svofski/vector06cc/doc/tangnano9k/WM8978-pinout.jpg

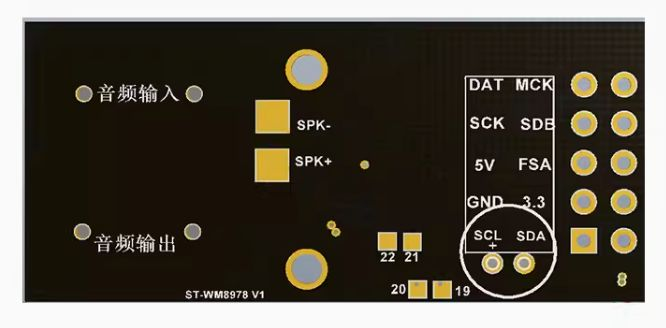
doc/tangnano9k/WM8978-pinout.jpg
