svofski/vector06cc/doc/tangnano9k/vsesp32s3.jpg

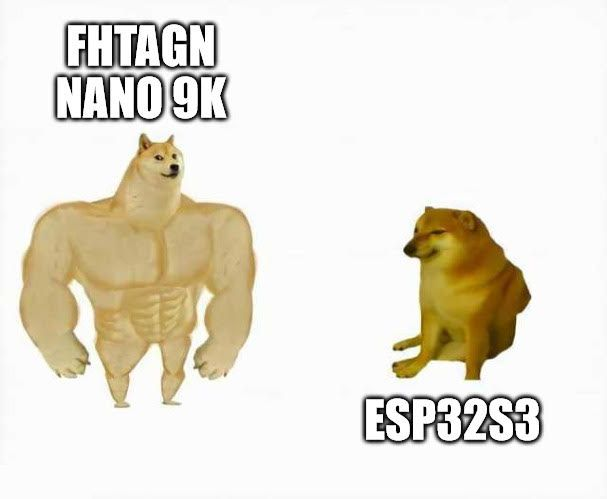
doc/tangnano9k/vsesp32s3.jpg
