svofski/vector06cc/hardware/vector06cc-tangnano9k/README.txt

vector06cc-specific carrier board for Tang Nano 9k
