svofski/vector06cc/doc/clocks-2.png

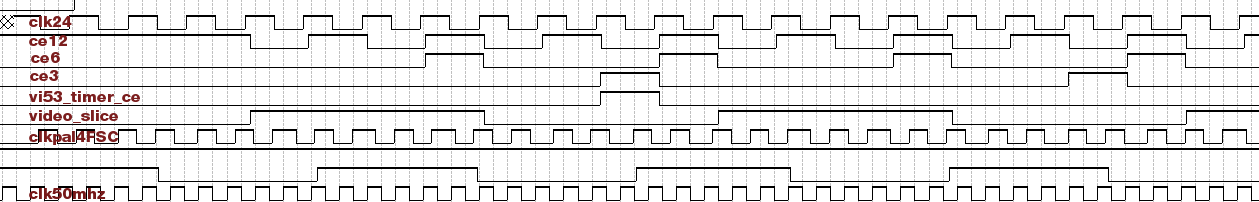
doc/clocks-2.png
