svofski/vector06cc/doc/computer.png

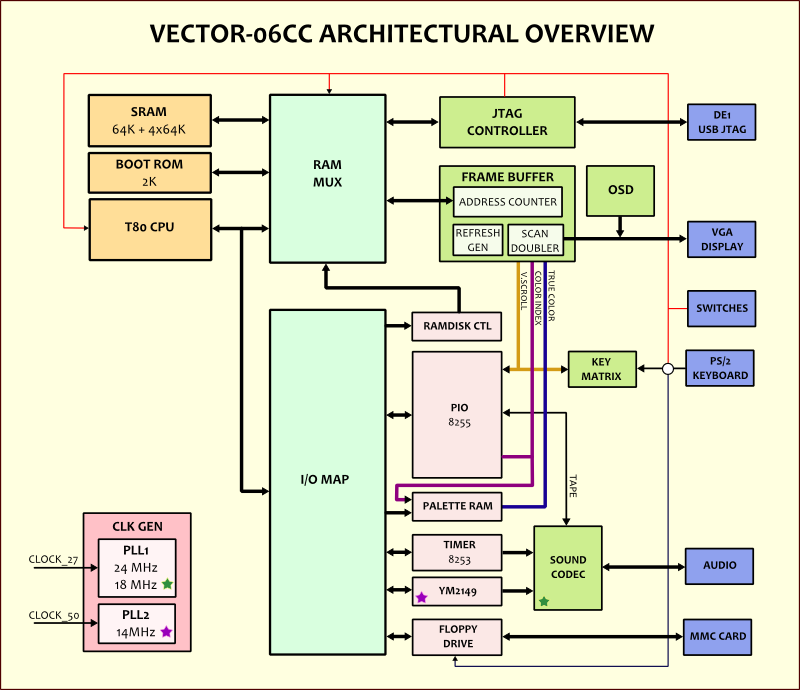
doc/computer.png
