svofski/vector06cc/doc/floppy.png

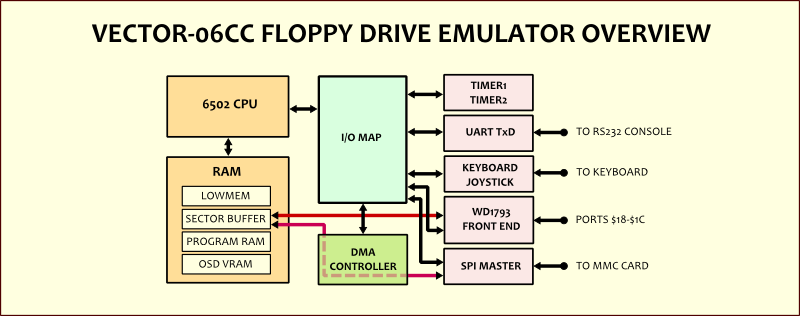
doc/floppy.png
