svofski/vector06cc/doc/jtag_statemachine.png

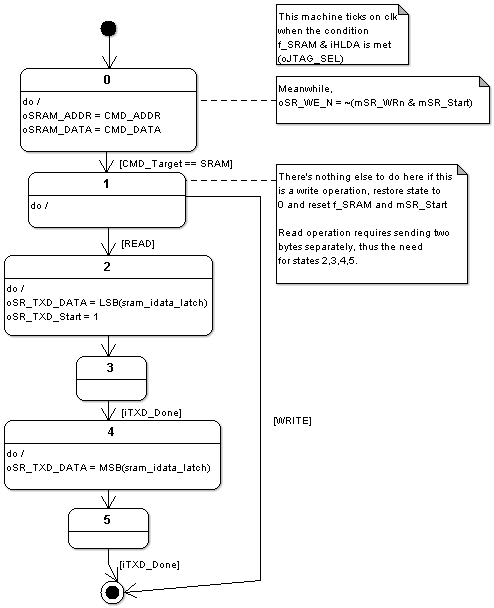
doc/jtag_statemachine.png
