svofski/vector06cc/doc/putupchik.jpg

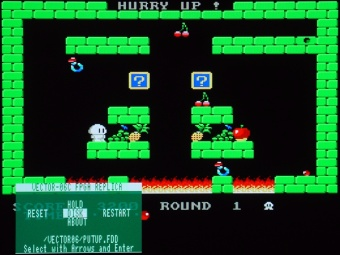
doc/putupchik.jpg
