svofski/vector06cc/doc/tangnano9k/keyboard-host-CH9350DS.jpg

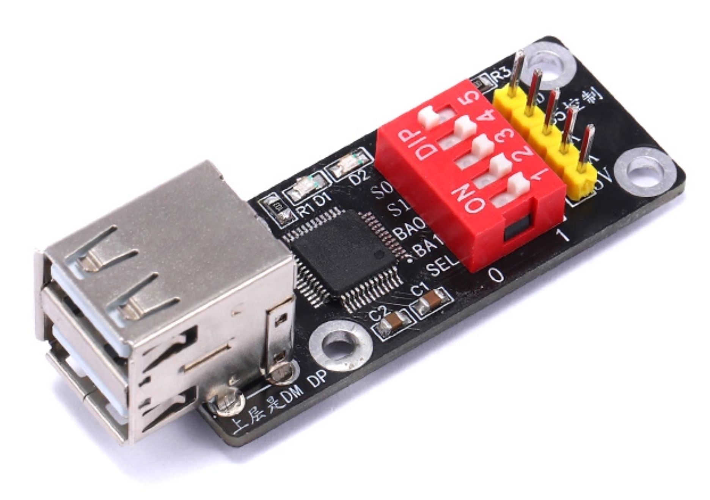
doc/tangnano9k/keyboard-host-CH9350DS.jpg
