svofski/vector06cc/doc/tangnano9k/pwm-output.jpg

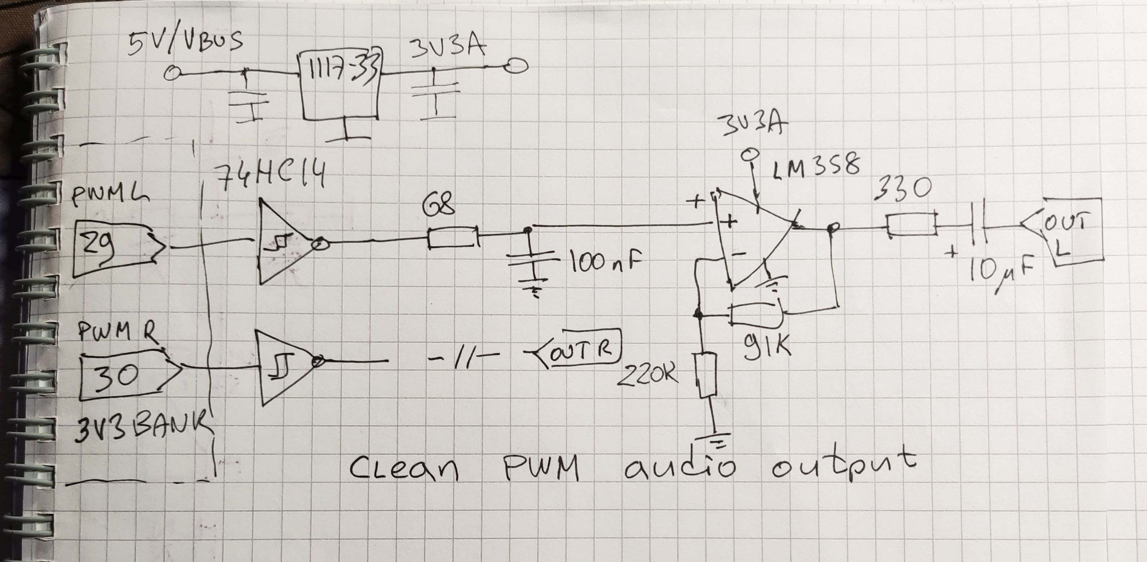
doc/tangnano9k/pwm-output.jpg
