svofski/vector06cc/doc/tangnano9k/vertical-interpolation.jpg

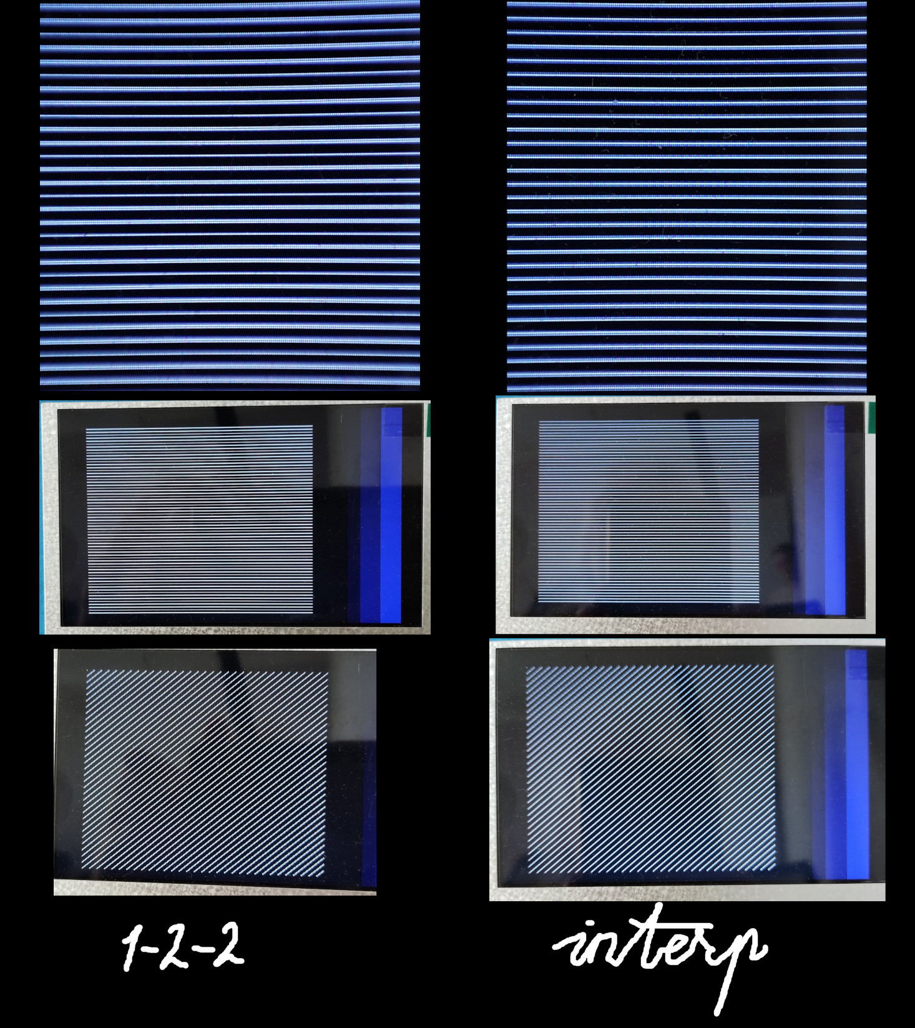
doc/tangnano9k/vertical-interpolation.jpg
