svofski/vector06cc/doc/tangnano9k/WM8978-board.jpg

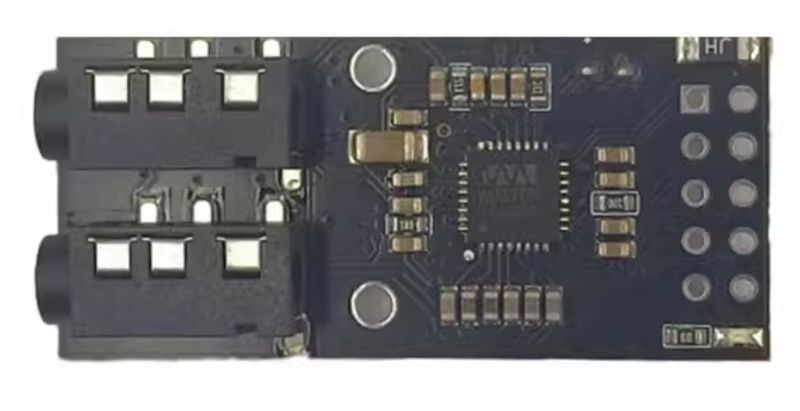
doc/tangnano9k/WM8978-board.jpg
