svofski/vector06cc/doc/tangnano9k/WM8978-schematic.jpg

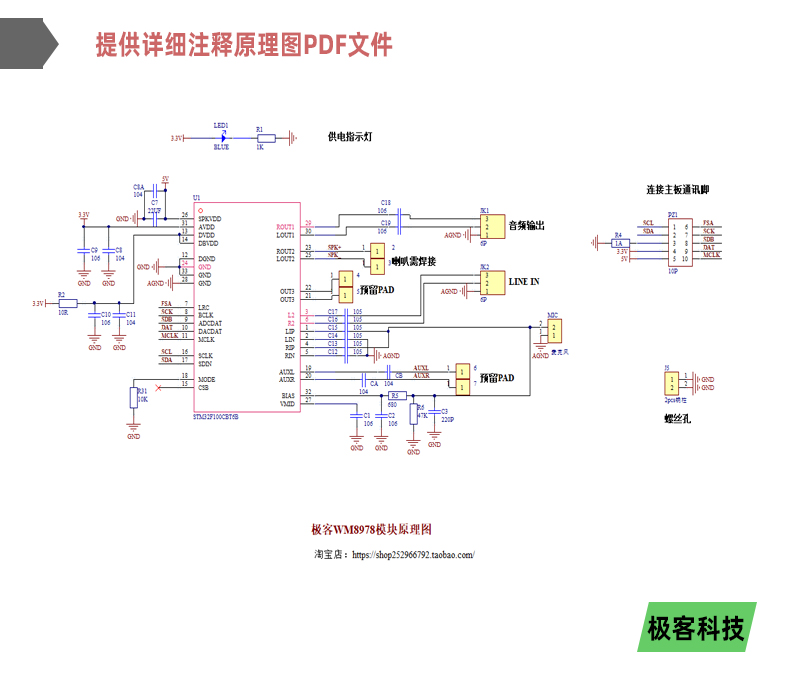
doc/tangnano9k/WM8978-schematic.jpg
