svofski/vector06cc/doc/wd_statemachine.png

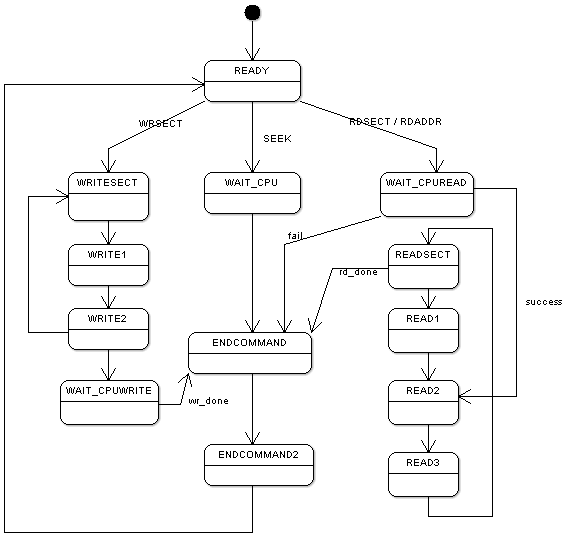
doc/wd_statemachine.png
