svofski/vector06cc/hardware/vector06cc-tangnano9k/kicad/v06cc_tn9k/v06cc_tn9k.kicad_pcb

## KiCad design hardware/vector06cc-tangnano9k/kicad/v06cc_tn9k/v06cc_tn9k.kicad_pcb (2024-10-20)

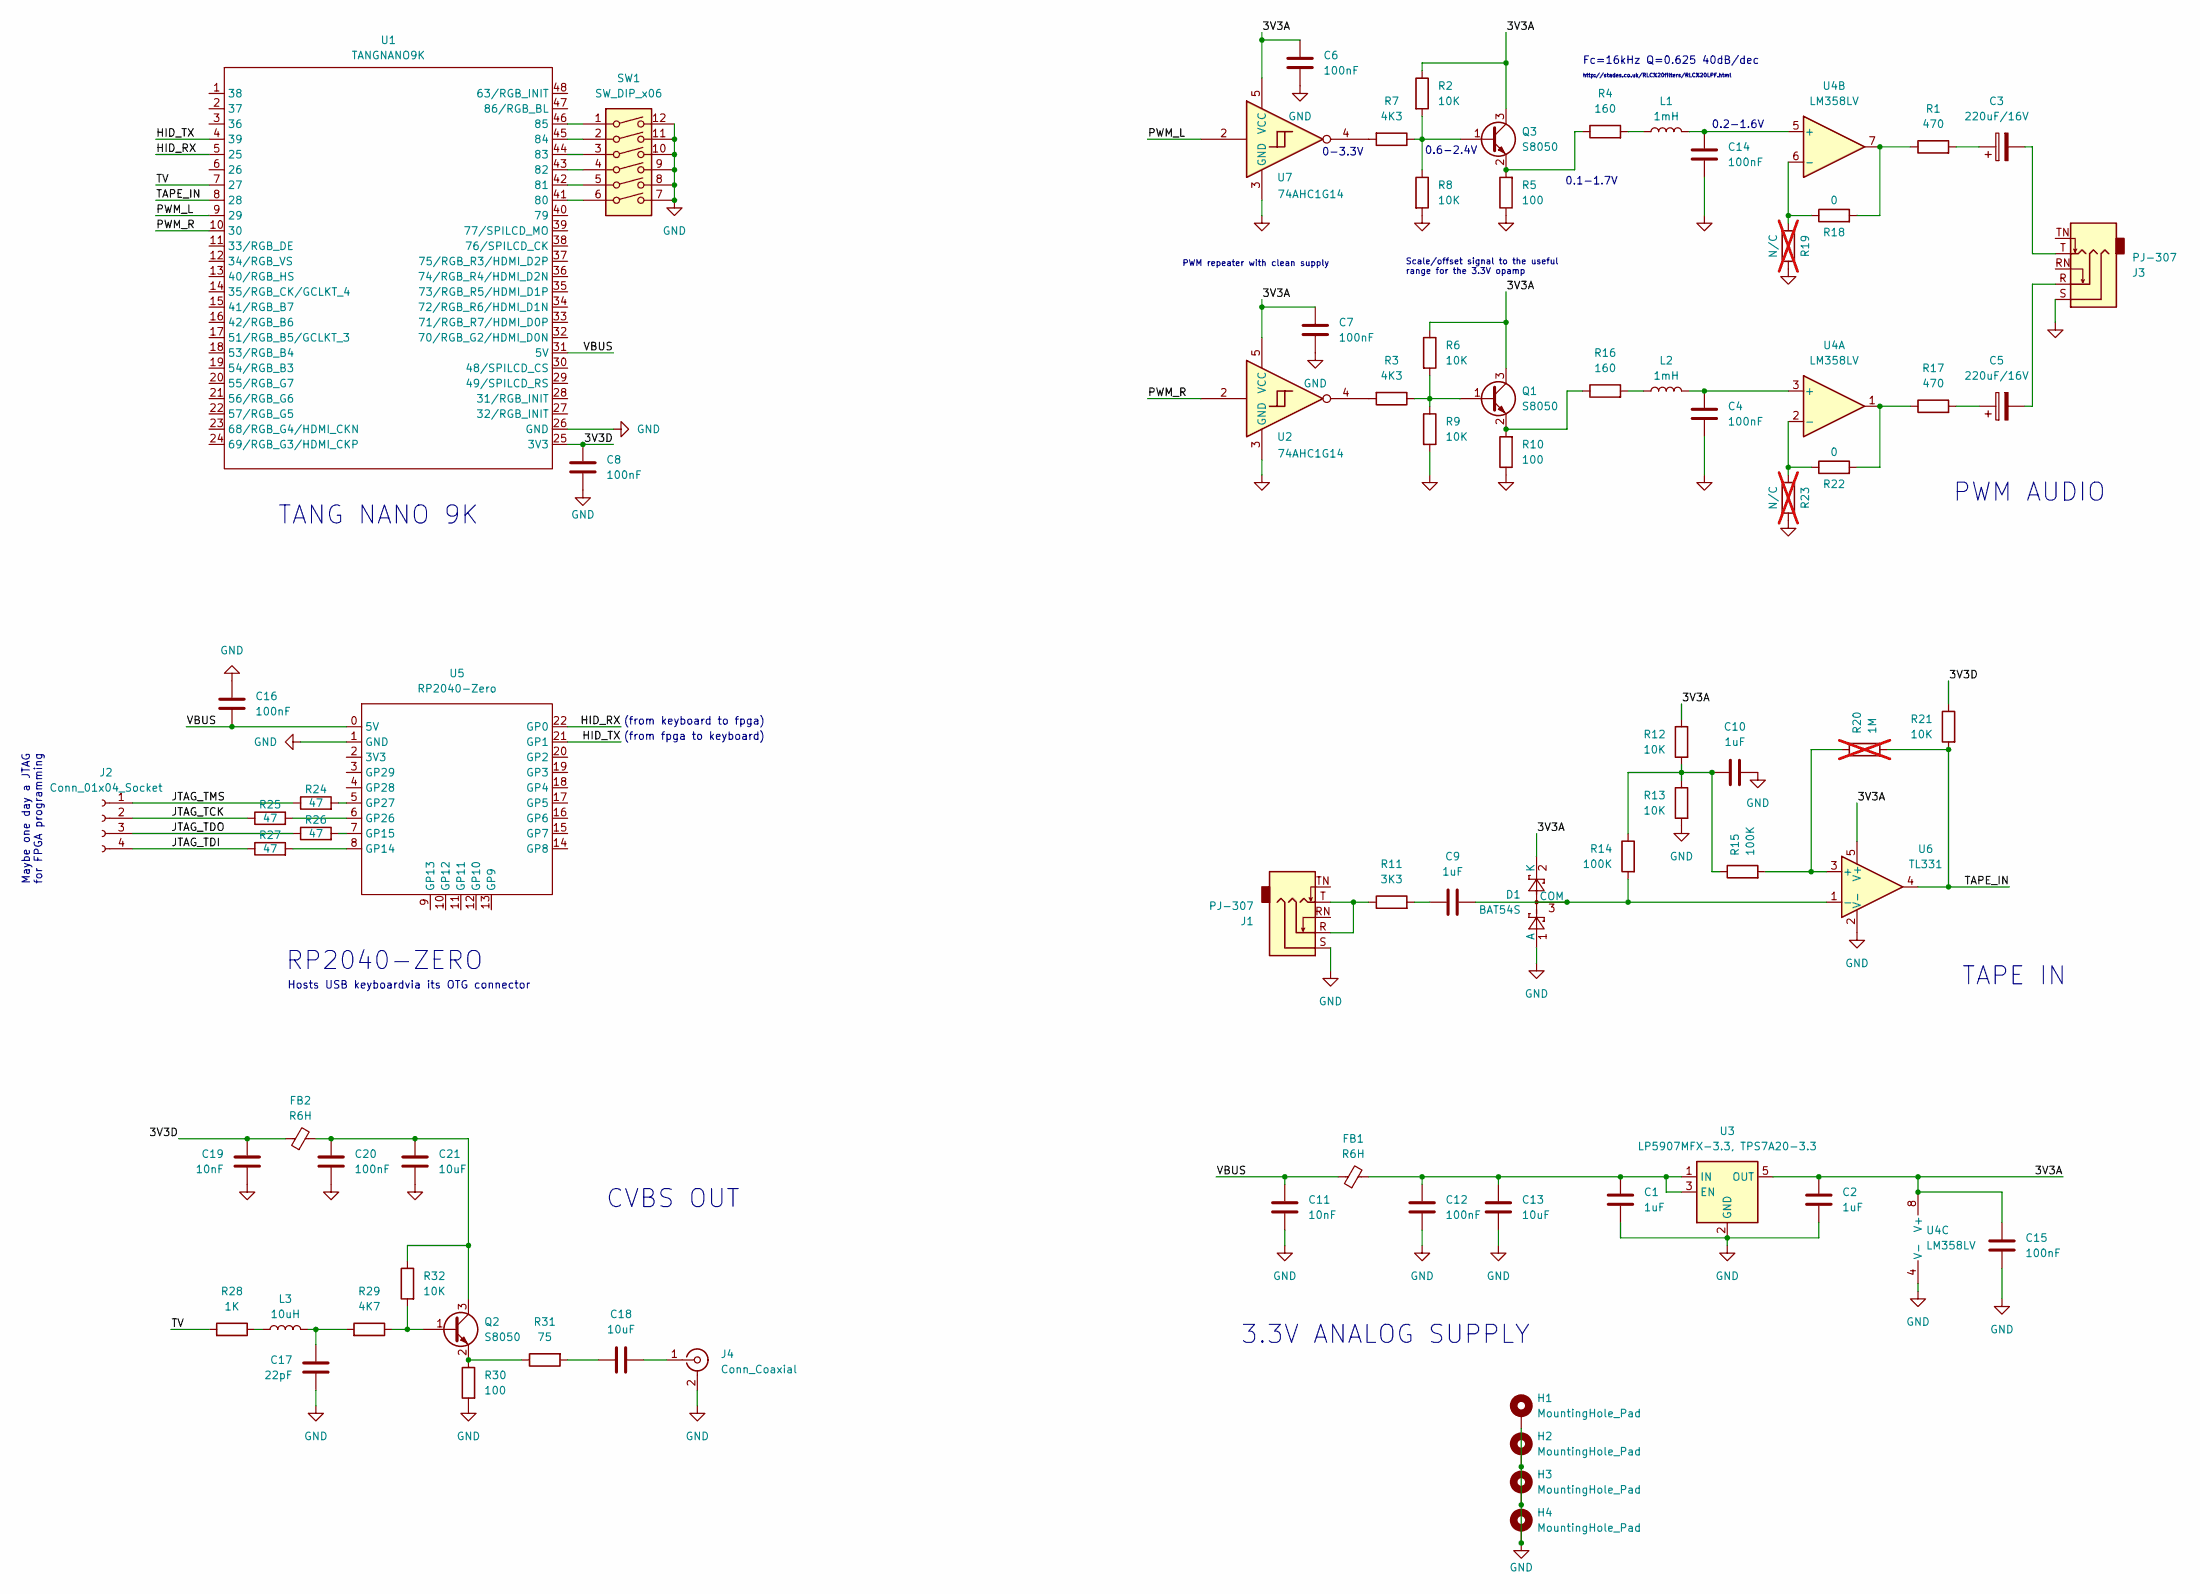
[picture p14: schematic v06cc_tn9k.kicad_sch, VECTOR06CC TANG NANO 9K CARRIER BOARD]

Parts:
C1, C2, C9, C10: 1uF; C_0805_2012Metric
C3, C5: 220uF/16V; CP_Elec_6.3x7.7
C4, C6, C7, C8, C12, C14, C15, C16, C20: 100nF; C_0603_1608Metric
C11, C19: 10nF; C_0805_2012Metric
C13, C18, C21: 10uF; C_0805_2012Metric
C17: 22pF; C_0603_1608Metric
D1: BAT54S; SOT-23
FB1, FB2: R6H; L_Radial_D6.0mm_P4.00mm
H1, H2, H3, H4: MountingHole_Pad; MountingHole_3.2mm_M3_DIN965_Pad
J1, J3: PJ-307; Jack_3.5mm_CUI_SJ1-3525N_Horizontal
J2: Conn_01x04_Socket; PinSocket_1x04_P2.54mm_Vertical
J4: Conn_Coaxial; CUI_RCJ-013
L1, L2: 1mH; L_Radial_D7.2mm_P3.00mm_Murata_1700
L3: 10uH; L_0805_2012Metric
Q1, Q2, Q3: S8050; SOT-23
R1, R17: 470; R_0805_2012Metric
R2, R6, R8, R9, R12, R13, R21, R32: 10K; R_0805_2012Metric
R3, R7: 4K3; R_0805_2012Metric
R4, R16: 160; R_0805_2012Metric
R5, R10, R30: 100; R_0805_2012Metric
R11: 3K3; R_0805_2012Metric
R14, R15: 100K; R_0805_2012Metric
R18, R22: 0; R_0805_2012Metric
R19, R23: N/C; R_0805_2012Metric; not fitted
R20: 1M; R_0805_2012Metric; not fitted
R24, R25, R26, R27: 47; R_0805_2012Metric
R28: 1K; R_0805_2012Metric
R29: 4K7; R_0805_2012Metric
R31: 75; R_0805_2012Metric
SW1: SW_DIP_x06; SW_DIP_SPSTx06_Slide_9.78x17.42mm_W7.62mm_P2.54mm
U1: TANGNANO9K; TangNano9k
U2, U7: 74AHC1G14; SOT-23-5
U3: LP5907MFX-3.3, TPS7A20-3.3; SOT-23-5
U4: LM358LV; SOIC-8_3.9x4.9mm_P1.27mm
U5: RP2040-Zero; rp2040-zero
U6: TL331; SOT-23-5

Connections:
/3V3A: C2.1, C6.2, C7.2, C15.2, D1.2 (K), Q1.3 (C), Q3.3 (C), R2.1, R6.1, R12.1, U2.5 (VCC), U3.5 (OUT), U4.8 (V+), U6.5 (V+), U7.5 (VCC)
/3V3D: C8.2, C19.1, FB2.1, R21.1, U1.25 (3V3)
/HID_RX: U1.5 (25), U5.22 (GP0)
/HID_TX: U1.4 (39), U5.21 (GP1)
/JTAG_TCK: J2.2, R25.1
/JTAG_TDI: J2.4, R27.1
/JTAG_TDO: J2.3, R26.1
/JTAG_TMS: J2.1, R24.1
/PWM_L: U1.9 (29), U7.2
/PWM_R: U1.10 (30), U2.2
/TAPE_IN: R20.2, R21.2, U1.8 (28), U6.4
/TV: R28.2, U1.7 (27)
/VBUS: C11.1, C16.1, FB1.1, U1.31 (5V), U5.0 (5V)
GND: C1.2, C2.2, C4.1, C6.1, C7.1, C8.1, C10.2, C11.2, C12.2, C13.2, C14.1, C15.1, C16.2, C17.1, C19.2, C20.2, C21.2, D1.1 (A), H1.1, H2.1, H3.1, H4.1, J1.S, J3.S, J4.2 (Ext), R5.1, R8.2, R9.2, R10.1, R13.2, R19.1, R23.1, R30.2, SW1.7, SW1.8, SW1.9, SW1.10, SW1.11, SW1.12, U1.26 (GND), U2.3 (GND), U3.2 (GND), U4.4 (V-), U5.1 (GND), U6.2 (V-), U7.3 (GND)
unnamed: C3.1, R1.2
unnamed: C3.2, J3.T
unnamed: C5.1, R17.2
unnamed: C5.2, J3.R
unnamed: C9.1, R11.2
unnamed: C10.1, R12.2, R13.1, R14.1, R15.1
unnamed: C17.2, L3.1, R29.2
unnamed: C18.1, R31.2
unnamed: C9.2, D1.3 (COM), R14.2, U6.1 (-)
unnamed: J1.R, J1.T, R11.1
unnamed: C18.2, J4.1 (In)
unnamed: L1.1, R4.2
unnamed: L2.1, R16.2
unnamed: L3.2, R28.1
unnamed: Q1.1 (B), R3.1, R6.2, R9.1
unnamed: Q1.2 (E), R10.2, R16.1
unnamed: Q2.1 (B), R29.1, R32.2
unnamed: C20.1, C21.1, FB2.2, Q2.3 (C), R32.1
unnamed: Q2.2 (E), R30.1, R31.1
unnamed: Q3.1 (B), R2.2, R7.1, R8.1
unnamed: Q3.2 (E), R4.1, R5.2
unnamed: R1.1, R18.2, U4.7
unnamed: R3.2, U2.4
unnamed: R7.2, U7.4
unnamed: R17.1, R22.2, U4.1
unnamed: SW1.6, U1.41 (80)
unnamed: SW1.5, U1.42 (81)
unnamed: SW1.4, U1.43 (82)
unnamed: SW1.3, U1.44 (83)
unnamed: SW1.2, U1.45 (84)
unnamed: SW1.1, U1.46 (85)
unnamed: C1.1, C12.1, C13.1, FB1.2, U3.1 (IN), U3.3 (EN)
unnamed: C4.2, L2.2, U4.3 (+)
unnamed: R22.1, R23.2, U4.2 (-)
unnamed: C14.2, L1.2, U4.5 (+)
unnamed: R18.1, R19.2, U4.6 (-)
unnamed: R27.2, U5.8 (GP14)
unnamed: R26.2, U5.7 (GP15)
unnamed: R25.2, U5.6 (GP26)
unnamed: R24.2, U5.5 (GP27)
unnamed: R15.2, R20.1, U6.3 (+)

Notes on the sheet:
PWM AUDIO
Hosts USB keyboardvia its OTG connector
(from keyboard to fpga)
http://stades.co.uk/RLC%20filters/RLC%20LPF.html
Maybe one day a JTAG for FPGA programming
3.3V ANALOG SUPPLY
0.6-2.4V
0.2-1.6V
Scale/offset signal to the useful range for the 3.3V opamp
PWM repeater with clean supply
(from fpga to keyboard)
0.1-1.7V
RP2040-ZERO
Fc=16kHz Q=0.625 40dB/dec
TAPE IN
0-3.3V
CVBS OUT
TANG NANO 9K

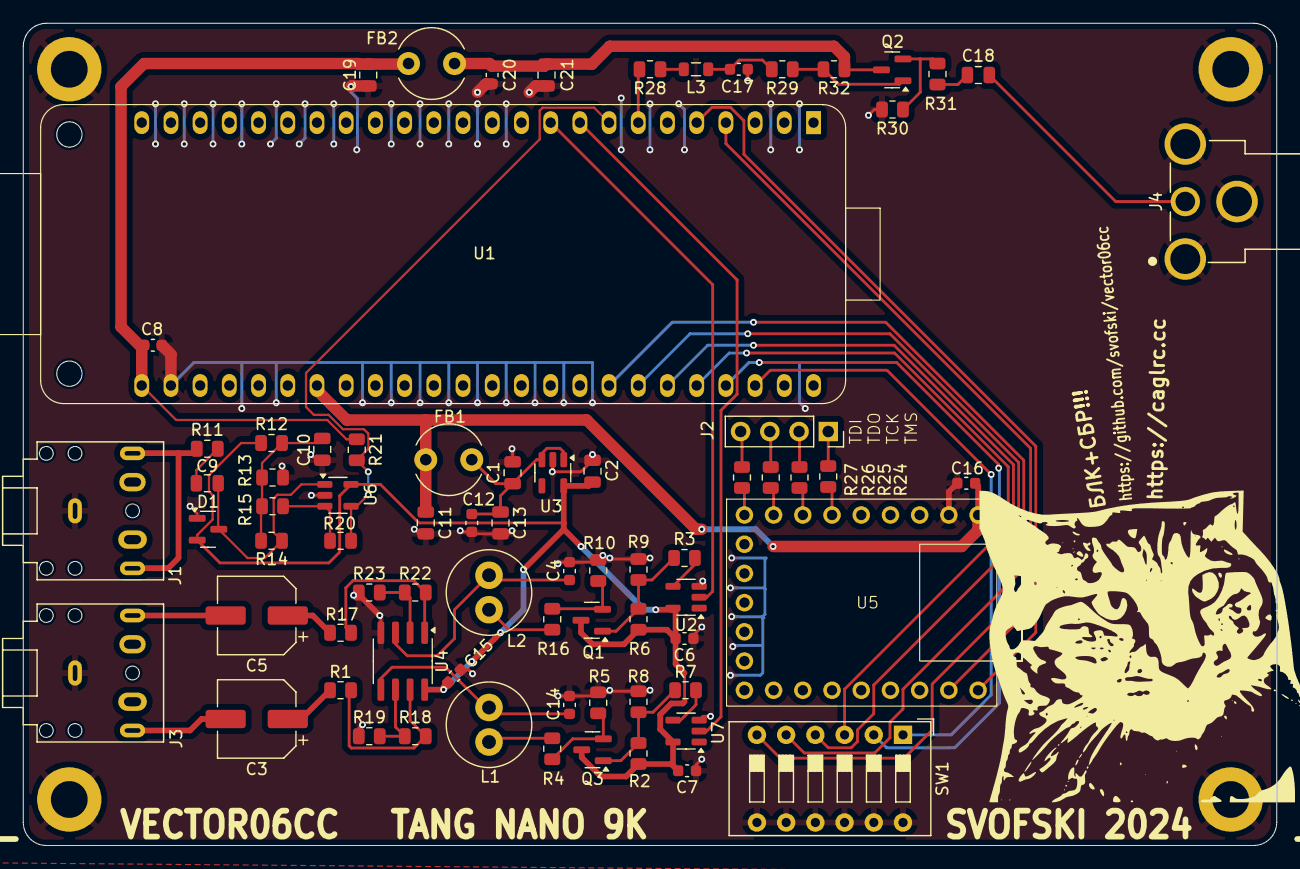
[picture p15: board v06cc_tn9k.kicad_pcb from above]

Board: 2 copper layers, 109.0 x 71.5 mm, 78 parts (0 on the bottom side), 55 nets.
