svofski/vector06cc/pico/v06c_usbhid/main.c

/* 
 * The MIT License (MIT)
 *
 * Copyright (c) 2019 Ha Thach (tinyusb.org)
 *
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
 */

#include <stdlib.h>
#include <stdio.h>
#include <string.h>

#include "bsp/board.h"
#include "tusb.h"

#include "matrix.h"

//--------------------------------------------------------------------+
// MACRO CONSTANT TYPEDEF PROTYPES
//--------------------------------------------------------------------+
void led_blinking_task(void);

extern void cdc_app_task(void);
extern void hid_app_task(void);

/*------------- MAIN -------------*/
int main(void)
{
  board_init();

  printf("TinyUSB Host CDC MSC HID Example\r\n");

  // init host stack on configured roothub port
  tuh_init(BOARD_TUH_RHPORT);
  matrix_init();

  while (1)
  {
    // tinyusb host task
    tuh_task();

    led_blinking_task();
    cdc_app_task();
    hid_app_task();
  }

  return 0;
}

//--------------------------------------------------------------------+
// TinyUSB Callbacks
//--------------------------------------------------------------------+

void tuh_mount_cb(uint8_t dev_addr)
{
  // application set-up
  printf("A device with address %d is mounted\r\n", dev_addr);
}

void tuh_umount_cb(uint8_t dev_addr)
{
  // application tear-down
  printf("A device with address %d is unmounted \r\n", dev_addr);
}


//--------------------------------------------------------------------+
// Blinking Task
//--------------------------------------------------------------------+
void led_blinking_task(void)
{
  const uint32_t interval_ms = 1000;
  static uint32_t start_ms = 0;

  static bool led_state = false;

  // Blink every interval ms
  if ( board_millis() - start_ms < interval_ms) return; // not enough time
  start_ms += interval_ms;

  board_led_write(led_state);
  led_state = 1 - led_state; // toggle
}
