svofski/vector06cc/src/tangnano9k/psram/psram_controller.v

//
// PSRAM/HyperRAM controller for Tang Nano 9K / Gowin GW1NR-LV9QN88PC6/15.
// Feng Zhou, 2022.8
//
// This is a word or byte based, non-bursting controller for accessing the on-chip HyperRAM.
// - 1:1 clock design. Memory and main logic work under the same clock.
// - Low latency. Under default settings, write latency is 7 cycles (1x) or 10 cycles (2x). 
//   Read latency is 12 cycles (1x) or 15 cycles(2x). In my test, 2x latency happens about 
//   0.05% of time.

// Modified by svofski 19.10.2024: updated FSM to case

`default_nettype wire

module PsramController #(
    parameter FREQ=81_000_000,// Actual clk frequency, to time 150us initialization delay
    parameter LATENCY=3       // tACC (Initial Latency) in W955D8MBYA datasheet:
                              // 3 (max 83Mhz), 4 (max 104Mhz), 5 (max 133Mhz) or 6 (max 166Mhz)
) (
    input clk,
    input clk_p,              // phase-shifted clock for driving O_psram_ck
    input resetn,
    output resetn_o,          // 1 after config done, use as system reset for the rest of the system
    input read,               // Set to 1 to read from RAM
    input write,              // Set to 1 to write to RAM
    input [21:0] addr,        // Byte address to read / write
    input [15:0] din,         // Data word to write
    input byte_write,         // When writing, only write one byte instead of the whole word. 
                              // addr[0]==1 means we write the upper half of din. lower half otherwise.
    input rdv,                // vram 32-bit aligned read
    output reg [15:0] dout,   // Last read data. Read is always word-based.
    output reg [15:0] dout2,  // second wrod
    output busy,              // 1 while an operation is in progress

    `ifdef PSRAM_INTERNAL_CPUBYTE
    input cpu_byte_sel,       // for early data retrieval
    output reg [7:0] cpu_byte,    // cpu_byte_sel ? dout[15:8] : dout[7:0]
    `endif

    output reg memcpubusy,        // busy for cpu
    output reg memvidbusy,        // busy for video
    output reg rdcpu_finished,    // cpu data ready

    `ifdef PSRAM_INTERNAL_VDATA
    output reg [31:0] vdata,      // video data 32 bits
    `endif

    // HyperRAM physical interface. Gowin interface is for 2 dies. 
    // We currently only use the first die (4MB).
    output [1:0] O_psram_ck,
    inout  [1:0] IO_psram_rwds,
    inout  [15:0] IO_psram_dq,
    output [1:0] O_psram_cs_n
);

reg [2:0] state;
localparam [2:0] INIT_ST = 3'd0;
localparam [2:0] CONFIG_ST= 3'd1;
localparam [2:0] IDLE_ST = 3'd2;
localparam [2:0] READ_ST = 3'd3;
localparam [2:0] WRITE_ST = 3'd4;

reg cfg_now, dq_oen, ram_cs_n, ck_e, ck_e_p;
reg wait_for_rd_data, wait_for_rd_data2;
reg ub;                     // 1 for upper byte
reg [15:0] w_din;
reg [23:0] cycles_sr;       // shift register counting cycles
reg [63:0] dq_sr;           // shifts left 8-bit every cycle

// DDR input output signals
wire [7:0] dq_out_ris = dq_sr[63:56];
wire [7:0] dq_out_fal = dq_sr[55:48];
wire [7:0] dq_in_ris;
wire [7:0] dq_in_fal;
reg rwds_out_ris, rwds_out_fal, rwds_oen;
wire rwds_in_ris, rwds_in_fal;
reg additional_latency;

// helpful higher level states
reg rdv_later;
wire rdv_combined = rdv_later | rdv;

reg write_later;
wire write_combined = write_later | write;

reg read_later;
wire read_combined = read_later | read;
//wire write_combined = write;

assign resetn_o = (state != CONFIG_ST);
assign busy = (state != IDLE_ST);

localparam [3:0] CR_LATENCY = LATENCY == 3 ? 4'b1110 :
                              LATENCY == 4 ? 4'b1111 :
                              LATENCY == 5 ? 4'b0 :
                              LATENCY == 6 ? 4'b0001 : 4'b1110;

// Main FSM for HyperRAM read/write
always @(posedge clk) begin
    cycles_sr <= {cycles_sr[22:0], 1'b0};
    dq_sr <= {dq_sr[47:0], 16'b0};          // shift 16-bits each cycle
    ck_e_p <= ck_e;

    case (state)
    INIT_ST:
        begin
            if (cfg_now) 
            begin
                cycles_sr <= 24'b1;
                ram_cs_n <= 0;
                state <= CONFIG_ST;
            end
        end
    CONFIG_ST:
        begin
            if (cycles_sr[0]) begin
                //dq_sr <= {8'h60, 8'h00, 8'h01, 8'h00, 8'h00, 8'h00, 8'h8f, CR_LATENCY, 4'h7};      // last byte, 'e' (3 cycle latency max 83Mhz), '7' (variable 1x/2x latency)
                dq_sr <= {8'h60, 8'h00, 8'h01, 8'h00, 8'h00, 8'h00, 8'h8f, CR_LATENCY, 4'h6};      // last byte, 'e' (3 cycle latency max 83Mhz), '7' (variable 1x/2x latency)
                dq_oen <= 0;
                ck_e <= 1;      // this needs to be earlier 1 cycle to allow for phase shifted clk_p
            end 
            if (cycles_sr[4]) begin
                state <= IDLE_ST;
                ck_e <= 0;
                cycles_sr <= 24'b1;
                dq_oen <= 1;
                ram_cs_n <= 1;
            end
        end
    IDLE_ST:
        begin
            rwds_oen <= 1;
            ck_e <= 0;
            ram_cs_n <= 1;

            // cpu_rd / cpu_wr priority high
            // rdvid priority low

            //`ifdef PSRAM_INTERNAL_VDATA
            //if (memvidbusy) vdata <= {dout2, dout};
            //`endif

            {memcpubusy,memvidbusy,rdcpu_finished} <= 3'b000;
            if (read_combined | write_combined | rdv_combined) 
            begin
                // start read/write operation (W955D8MBYA Table 2)
                //47     = r/w (1 = read, 0 = write) 
                //46   0 = memory space
                //45   1 = burst type = register read/write: "For register read, only the first two bytes of read data is valid"
                //      14-bit                     18-bit   13-bit   3-bit             total 48-bit CA
                //xx = read_combined ? 1'b1 : write_combined ? 1'b0 : 1'b1 /* rdv_combined */
                //dq_sr <= {rdv | ~write_combined, 13'b000_0000_0000_00, addr[21:4], 13'b0, addr[3:1], 16'b0000_0100_1101_0100};
                dq_sr <= {read_combined ? 1'b1 : write_combined ? 1'b0 : 1'b1, 13'b000_0000_0000_00, addr[21:4], 13'b0, addr[3:1], 16'b0000_0100_1101_0100};
                if (read_combined | write_combined)
                    memcpubusy <= 1'b1;
                else
                    memvidbusy <= 1'b1;

                if ((read_combined | write_combined) & rdv)
                    rdv_later <= rdv;

                ram_cs_n <= 0;
                ck_e <= 1;
                dq_oen <= 0;
                {wait_for_rd_data, wait_for_rd_data2} <= 2'b00;
                w_din <= din;
                cycles_sr <= 32'b10;    // start from cycle 1
                state <= rdv ? READ_ST : 
                    write_combined ? WRITE_ST : READ_ST;
            end
        end

    READ_ST:
        begin
            // latch conflicting requests
            if (memvidbusy && read) read_later <= 1;
            if (memvidbusy && write) write_later <= 1;
            if (memcpubusy && rdv) rdv_later <= 1;

            if (cycles_sr[3]) begin
                // command sent, now wait for result
                dq_oen <= 1;
            end 
            if (cycles_sr[9])
                wait_for_rd_data <= 1;
            if (wait_for_rd_data && (rwds_in_ris ^ rwds_in_fal)) begin     // sample rwds falling edge to get a word / \_
                dout <= {dq_in_ris, dq_in_fal};
                wait_for_rd_data <= 0;

                if (memvidbusy) 
                    wait_for_rd_data2 <= 1;   // read second word
                else
                begin
                    ram_cs_n <= 1;            // cpu read finished
                    ck_e <= 0;
                    rdcpu_finished <= 1'b1;
                    read_later <= 0;
                    state <= IDLE_ST;

                    `ifdef PSRAM_INTERNAL_CPUBYTE
                    cpu_byte <= cpu_byte_sel ? dq_in_ris : dq_in_fal;
                    `endif
                end
            end
            else
            if (wait_for_rd_data2 && (rwds_in_ris ^ rwds_in_fal)) begin     // sample rwds falling edge to get a word / \_
                dout2 <= {dq_in_ris, dq_in_fal};
                wait_for_rd_data2 <= 0;
                ram_cs_n <= 1;
                ck_e <= 0;
                rdv_later <= 0;
                state <= IDLE_ST;
                
                `ifdef PSRAM_INTERNAL_VDATA
                vdata <= {dq_in_ris, dq_in_fal, dout};
                memvidbusy <= 1'b0; // is it useful to drop it early?
                `endif
            end
        end

    WRITE_ST:
        begin
            // latch conflicting requests
            if (rdv) rdv_later <= 1;

            if (cycles_sr[5])
                `ifdef PSRAM_WRITE_ALWAYS_ADD_LATENCY
                // it seems that it's fine when it's always present, maybe a tad
                // more stable
                additional_latency <= 1'b1;
                `else
                additional_latency <= rwds_in_fal;  // sample RWDS to see if we need additional latency
                `endif

            // Write timing is trickier - we sample RWDS at cycle 5 to determine whether we need to wait another tACC.
            // If it is low, data starts at 2+LATENCY. If high, then data starts at 2+LATENCY*2.
            if (cycles_sr[2+LATENCY] && (LATENCY == 3 ? ~rwds_in_fal : ~additional_latency)
                || cycles_sr[2+LATENCY*2]) 
            begin
                rwds_oen <= 0;
                rwds_out_ris <= byte_write ? ~addr[0] : 1'b0;       // RWDS is data mask (1 means not writing)
                rwds_out_fal <= byte_write ? addr[0] : 1'b0;
                dq_sr[63:48] <= w_din;
                write_later <= 0;
                state <= IDLE_ST;
            end

            write_later <= 1'b0;
        end
    default:
        state <= INIT_ST;
    endcase

    if (~resetn) begin
        state <= INIT_ST;
        ram_cs_n <= 1;
        ck_e <= 0;
        {read_later, write_later, rdv_later, memcpubusy, memvidbusy, rdcpu_finished} <= 0;
    end 
end

// 150us initialization delay
//
// Generate cfg_now pulse after 150us delay
//
localparam INIT_TIME = FREQ / 1000 * 160 / 1000;
localparam CNT_W = $clog2(INIT_TIME+1);
reg  [CNT_W:0]   rst_cnt;
reg rst_done, rst_done_p1, cfg_busy;
  
always @(posedge clk) begin
    rst_done_p1 <= rst_done;
    cfg_now     <= rst_done & ~rst_done_p1;// Rising Edge Detect

    if (rst_cnt != INIT_TIME) begin      // count to 160 us
        rst_cnt  <= rst_cnt[CNT_W:0] + 1;
        rst_done <= 0;
        cfg_busy <= 1;
    end else begin
        rst_done <= 1;
        cfg_busy <= 0;
    end

    if (~resetn) begin
        rst_cnt  <= 15'd0;
        rst_done <= 0;
        cfg_busy <= 1;
    end
end

// Tristate DDR output
wire dq_out_tbuf[7:0];
wire dq_oen_tbuf[7:0];
wire cs_n_tbuf, rwds_tbuf, rwds_oen_tbuf, ck_tbuf;
ODDR oddr_cs_n(
    .CLK(clk), .D0(ram_cs_n), .D1(ram_cs_n), .Q0(cs_n_tbuf)
);
assign O_psram_cs_n[0] = cs_n_tbuf;
ODDR oddr_rwds(
    .CLK(clk), .D0(rwds_out_ris), .D1(rwds_out_fal), .TX(rwds_oen), .Q0(rwds_tbuf), .Q1(rwds_oen_tbuf)
);
assign IO_psram_rwds[0] = rwds_oen_tbuf ? 1'bz : rwds_tbuf;

genvar i1;
generate
    for (i1=0; i1<=7; i1=i1+1) begin: gen_i1
        ODDR oddr_dq_i1(
            .CLK(clk), .D0(dq_out_ris[i1]), .D1(dq_out_fal[i1]), .TX(dq_oen), .Q0(dq_out_tbuf[i1]), .Q1(dq_oen_tbuf[i1])
        );
        assign IO_psram_dq[i1] = dq_oen_tbuf[i1] ? 1'bz : dq_out_tbuf[i1];
    end
endgenerate
// Note: ck uses phase-shifted clock clk_p
ODDR oddr_ck(
    .CLK(clk_p), .D0(ck_e_p), .D1(1'b0), .Q0(ck_tbuf)
);
assign O_psram_ck[0] = ck_tbuf;


// Tristate DDR input
IDDR iddr_rwds(
    .CLK(clk), .D(IO_psram_rwds[0]), .Q0(rwds_in_ris), .Q1(rwds_in_fal)
);
genvar i2;
generate
    for (i2=0; i2<=7; i2=i2+1) begin: gen_i2
        IDDR iddr_dq_i2(
            .CLK(clk), .D(IO_psram_dq[i2]), .Q0(dq_in_ris[i2]), .Q1(dq_in_fal[i2])
        );
    end
endgenerate

endmodule
