svofski/vector06cc/src/tangnano9k/vector06cc.v

// ====================================================================
//                         VECTOR-06C FPGA REPLICA
//
//               Copyright (C) 2007-2024 Viacheslav Slavinsky
//
// This core is distributed under modified BSD license. 
// For complete licensing information see LICENSE.TXT.
// -------------------------------------------------------------------- 
//
// An open implementation of Vector-06C home computer
//
// Author: Viacheslav Slavinsky
// 
// SDRAM version and some other changes: Ivan Gorodetsky
//
// Design File: vector06cc.v
//
// Top-level design file of Vector-06C replica.
//
// Switches, as they are configured now:
//  SW1:SW0         red LED[7:0] display selector: 
//                      00: Data In
//                      01: Data Out
//                      11: registered Data Out
//
//  SW3:SW2         green LED group display selector
//                      00: registered CPU status word
//                      01: keyboard status/testpins
//                      10: RAM disk test pins
//                      11: WR_n, io_stack, SRAM_ADDR[17:15] (RAM disk page)
//
//  SW4         1 = PAL field phase alternate (should be on for normal tv's)
//  SW5         1 = CVBS composite output on VGA R,G,B pins 
//                  (connect them together and feed to tv)
//
//  SW6         unused
//  SW7         unused
//
//              These must be both "1" for normal operation:
//  KEY2:SW8                00: single-clock, tap clock by KEY[1]
//                  01: warp mode: between 6 and 12 MHz
//                  10: slow clock, code is executed at eyeballable speed
//                  11: normal Vector-06C speed, full compatibility mode
//
//  SW9         unused
//
// --------------------------------------------------------------------


//`default_nettype none

`include "config.v"

module vector06cc(
    input           XTAL_27MHZ,
    input           SYS_RESETN,
    input           BUTTON,


`ifdef WITH_HDMI
    // HDMI
    output          tmds_clk_n,
    output          tmds_clk_p,
    output [2:0]    tmds_d_n,
    output [2:0]    tmds_d_p,
`endif

`ifdef WITH_LCD
    output          LCD_CLK,
    output          LCD_HSYNC,
    output          LCD_VSYNC,
    output          LCD_DEN,
    output  [4:0]   LCD_R,
    output  [5:0]   LCD_G,
    output  [4:0]   LCD_B,
`endif
    //////////////////    SD Card Interface   ////////////////////////
    input           SD_DAT,                 //  SD Card Data            (MISO)
    output          SD_DAT3,                //  SD Card Data 3          (CSn)
    output          SD_CMD,                 //  SD Card Command Signal  (MOSI)
    output          SD_CLK,                 //  SD Card Clock           (SCK)

    output          UART_TX,
    input           UART_RX,

    input           HID_UART_RX,            // CH9350 HID USB adapter uart (57 AB 01 xx xx xx xx xx xx xx xx)

    // pwm audio output
    output wire [1:0] BEEP,

    // i2s audio codec
    output          I2S_MCLK,
    output          I2S_BCLK,
    output          I2S_LRC,
    output          I2S_DACDAT,
    input           I2S_ADCDAT,
    // i2c codec config
    output          I2C_SCL,
    inout           I2C_SDA,

    output reg [5:0] LED,

    // PSRAM interface magic ports
    output wire [1:0] O_psram_ck,       // Magic ports for PSRAM to be inferred
    output wire [1:0] O_psram_ck_n,
    inout  wire [1:0] IO_psram_rwds,
    inout  wire [15:0] IO_psram_dq,
    output wire [1:0] O_psram_reset_n,
    output wire [1:0] O_psram_cs_n
);


wire  delayed_reset_n;    // when PSRAM ready

// CLOCK SETUP
wire mreset_n = delayed_reset_n & ~kbd_key_blkvvod;
wire mreset = !mreset_n;

wire clk24, clkAudio, clk48, clk48p;
wire ce12, ce6, ce6x, ce3, ce3f2, vi53_timer_ce, video_slice, pipe_ab;
wire clkpal4FSC = 0;    // no PAL modulator
wire clk_color_mod = 0; // no PAL color 

wire clk_psram, clk_psram_p;
wire clk_p5;

clockster clockmaker(
    .clk27(XTAL_27MHZ),     // input xtal, 27 mhz on fhtagn nano 9k
    .clk24(clk24),          // master clock
    .clk_psram(clk_psram),  // PSRAM clock
    .clk_psram_p(clk_psram_p),// PSRAM clock 90 deg
    .clkAudio(clkAudio),
    .clk_p5(clk_p5),
    .ce12(ce12), 
    .ce6(ce6),              // tv pixel clock
    .ce6x(ce6x),
    .ce3(ce3),              // cpu 
    .ce3f2(ce3f2),          // vm80a f2
    .video_slice(video_slice), 
    .pipe_ab(pipe_ab), 
    .ce1m5(vi53_timer_ce)
    );


wire tape_input, tape_input_wav;
wire [7:0]  ay_soundA,ay_soundB,ay_soundC;
wire [7:0]  rs_soundA,rs_soundB,rs_soundC;
wire [2:0]  vi53_out;
reg  [7:0]  CovoxData;

`ifdef WITH_HDMI_AUDIO
wire [31:0] hdmi_audio_sample;
wire        hdmi_audio_clk;
`endif

soundcodec soundnik(
    .clk24(clk24),
    .clk_pwm(clk_psram),
    //.clk_pwm(clk24),
    .pulses({tape_input_wav ^ vv55int_pc_out[0],vi53_out}), 
    .ay_soundA(ay_soundA),  //
    .ay_soundB(ay_soundB),  //
    .ay_soundC(ay_soundC),  //
    .rs_soundA(rs_soundA),  //
    .rs_soundB(rs_soundB),  //
    .rs_soundC(rs_soundC),  //
    .covox(CovoxData),
    .tapein(tape_input), 
    .reset_n(mreset_n),
    .o_pwm(BEEP)
`ifdef WITH_HDMI_AUDIO
    ,
    .hdmi_audio_clk(hdmi_audio_clk),
    .hdmi_audio_sample(hdmi_audio_sample)
`endif
`ifdef WITH_WM8978
    ,
    .oAUD_MCLK(I2S_MCLK),
    .oAUD_BCK(I2S_BCLK),
    .oAUD_LRCK(I2S_LRC),
    .oAUD_DACDAT(I2S_DACDAT),
    .iAUD_ADCDAT(I2S_ADCDAT)
`endif
    );

`ifdef WITH_WM8978
I2C_AV_Config accfg0(
    .iCLK(clk24),
    .iRST_N(mreset_n),
    .I2C_SCLK(I2C_SCL),
    .I2C_SDAT(I2C_SDA));
`endif

`ifndef WITH_WM8978
    // i2s audio codec
    assign I2S_MCLK = 1'bz;
    assign I2S_BCLK = 1'bz;
    assign I2S_LRC = 1'bz;
    assign I2S_DACDAT = 1'bz;
    // i2c codec config
    assign I2C_SCL = 1'bz;
    assign I2C_SDA = 1'bz;
`endif

reg [15:0] slowclock;
always @(posedge clk24) if (ce3) slowclock <= slowclock + 1'b1;

reg  breakpoint_condition;

reg slowclock_enabled;
reg singleclock_enabled;
reg warpclock_enabled;

always @*
    {singleclock_enabled, slowclock_enabled, warpclock_enabled} = 3'b000;
    
wire singleclock;

reg cpu_ce;
always @* 
    casex ({singleclock_enabled, slowclock_enabled, warpclock_enabled, breakpoint_condition})
    4'bxxx1:
        cpu_ce <= 1'b0;
    4'b1xx0:
        cpu_ce <= singleclock;
    4'bx1x0:
        cpu_ce <= (slowclock == 0) & ce3;
    4'bxx10:
        cpu_ce <= ~ce12&~memcpubusy&~memvidbusy&~video_slice_my;
    4'b0000:
        cpu_ce <= ce3;
    endcase

reg[1:0] vid_cnt;
reg video_slice_my,video_slice_mymy;
always @(posedge video_slice)   {vid_cnt,video_slice_mymy}<={vid_cnt+2'b1,!vid_cnt[1]&vid_cnt[0]};
always @(posedge clk24) video_slice_my<=video_slice_mymy&video_slice;

//reg [15:0] clock_counter;
//always @(posedge clk24) begin
//    if (~RESET_n) 
//        clock_counter <= 0;
//    else if (cpu_ce & ~halt_ack) 
//        clock_counter <= clock_counter + 1'b1;
//end

/////////////////
// WAIT STATES //
/////////////////

// a very special waitstate generator
reg [4:0]   ws_counter = 0;
reg         ws_latch;
always @(posedge clk24) 
    if (~RESET_n)
        ws_counter <= 5'b0;
    else
        ws_counter <= ws_counter + 1'b1;

wire [3:0] ws_rom = ws_counter[4:1];
//wire ws_cpu_time = ws_rom[3:1] == 3'b101;
wire ws_cpu_time = ws_rom[3:1] == 3'b101;
wire ws_req_n = ~(DO[7] | ~DO[1]) | DO[4] | DO[6];  // == 0 when cpu wants cock

always @(posedge clk24)
begin: _ready_ctl
    if (~RESET_n)
        breakpoint_condition <= 1'b0;
    else
    begin
        breakpoint_condition <= sideload_halt;
        //if (cpu_ce)
        if (ce3)
        begin
            if (SYNC & ~warpclock_enabled) begin
                // if this is not a cpu slice (ws_rom[2]) and cpu wants access, latch the ws flag
                //if (~ws_req_n & ~ws_cpu_time) READY <= 0;
                READY <= 0; //### this works for T8080 but not for v80a
`ifdef WITH_BREAKPOINTS         
                if (singleclock) begin
                    breakpoint_condition <= sideload_halt;
                end
                else if (A == 16'h0100) begin
                    breakpoint_condition <= 1'b1;
                end
`else
                breakpoint_condition <= sideload_halt;
`endif
            end
        end
        // reset the latch when it's time
        if (ws_cpu_time) begin
            READY <= 1;
        end
    end
end


/////////////////
// CPU SECTION //
/////////////////
reg [1:0] reset_rq = 2'b00;
always @(posedge clk24)
begin: _RESET_sync
    //if (mreset | blksbr_reset_pulse)
    //    reset_rq <= 2'b01;
    ////if (~int_rq_hist & int_rq_tick & reset_rq[0])
    //if (~vga_vs & reset_rq[0])
    //    reset_rq <= 2'b10;  // set reset
    //if (reset_rq[1])
    //    reset_rq <= 2'b00;  // reset done

    case (reset_rq)
        2'b00: if (mreset | blksbr_reset_pulse) reset_rq <= 2'b01;
        2'b01: if (~vga_vs) reset_rq <= 2'b10;
        2'b10: reset_rq <= 2'b00;
    default:   reset_rq <= 2'b00;
    endcase
end
wire RESET_n = ~reset_rq[1];

//wire RESET_n = mreset_n & !blksbr_reset_pulse;
reg READY;
wire HOLD = osd_command_bushold | floppy_death_by_floppy;
wire INT = int_request;
wire INTE;
wire DBIN;
wire SYNC;
wire VAIT;
wire HLDA;
wire WR_n;

wire [15:0] VIDEO_A;
wire [15:0] A;
wire [7:0] DI;
wire [7:0] DO;


reg[7:0] status_word;
reg[9:0] gledreg;

wire [1:0] sw23 = {1'b0, 1'b0};

wire [7:0] kbd_keystatus = {kbd_mod_rus, kbd_key_shift, kbd_key_ctrl, kbd_key_rus, kbd_key_blksbr};

wire ram_read;
wire ram_read_pre;
wire ram_write_n;
wire io_write;
wire io_stack;
wire io_stack_pre;
wire io_read;
wire interrupt_ack;
wire halt_ack;
wire WRN_CPUCE = WR_n | ~cpu_ce;


`ifdef WITH_CPU
    `ifdef WITH_T8080
    T8080se CPU(RESET_n, clk24, cpu_ce, READY, HOLD, INT, INTE, DBIN, SYNC, VAIT, HLDA, WR_n, A, DI, DO);
wire inta_n;
    `endif

    `ifdef WITH_VM80A
wire cpu_aena, cpu_dena;

reg  [3:0] vm80a_reset_r = 4'b0000;
wire vm80a_reset = vm80a_reset_r[0];
always @(posedge clk24 or negedge RESET_n)
    if (~RESET_n) 
        vm80a_reset_r <= 4'b1111;
    else if (ce3f2)
        vm80a_reset_r <= {1'b0, vm80a_reset_r[3:1]};

vm80a_core CPUVM80A(
    .pin_clk(clk24),
    .pin_f1(cpu_ce),
    .pin_f2(ce3f2),
    .pin_reset(vm80a_reset),
    .pin_a(A),
    .pin_dout(DO),
    .pin_din(DI),
    .pin_aena(cpu_aena),
    .pin_dena(cpu_dena),
    .pin_hold(HOLD),
    .pin_hlda(cpu_hlda),
    .pin_ready(READY),
    .pin_wait(VAIT),
    .pin_int(INT),
    .pin_inte(INTE),
    .pin_sync(SYNC),
    .pin_dbin(DBIN),
    .pin_wr_n(WR_n));

    `endif
    
    assign ram_read = status_word[7];
    assign ram_write_n = status_word[1];
    assign io_write = status_word[4];
    assign io_stack = status_word[2];
    assign io_read  = status_word[6];
    assign halt_ack = status_word[3];
    assign interrupt_ack = status_word[0];

    // early signals
    assign ram_read_pre = SYNC & DO[7] & ~rom_access;
    assign io_stack_pre = SYNC & DO[2];

`else
    assign WR_n = 1;
    assign DO = 8'h00;
    assign A = 16'hffff;
    assign ram_read = 0;
    assign ram_write_n = 1;
    assign io_write = 0;
    assign io_stack = 0;
    assign io_read  = 0;
    assign interrupt_ack = 1;
`endif

wire cpu_m1 = SYNC & DO[5];
always @(posedge clk24) begin
    //if (cpu_ce) begin
    //    if (WR_n == 0) gledreg[7:0] <= DO;
    //    if (SYNC) begin
    //        status_word <= DO;
    //    end 
    //    
    //    address_bus_r <= address_bus[7:0];
    //end
    if (cpu_ce) begin
        if (WR_n == 0) gledreg[7:0] <= DO;
        if (SYNC) begin
            status_word <= DO;
        end 
        address_bus_r <= address_bus[7:0];
    end
        
    //if (SYNC)
    //    address_bus_r <= address_bus[7:0];
end

//always @(posedge clk24)
//    if (cpu_ce)
//        LED[5:0] <= status_word[5:0];


//////////////
// MEMORIES //
//////////////

wire[7:0] ROM_DO;
//bootrom bootrom(.address(A[10:0]),.clock(clk24),.q(ROM_DO));

bootrom bootrom(
    .ad(A[10:0]),   //input [10:0] ad
    .dout(ROM_DO),  //output [7:0] dout
    .clk(clk24),    //input clk
    .oce(1'b1),     //input oce
    .ce(1'b1),      //input ce
    .reset(1'b0)    //input reset
);


reg [7:0] address_bus_r;    // registered address for i/o

reg rom_access;
always @(posedge clk24) begin
    if (disable_rom)
        rom_access <= 1'b0;
    else
        rom_access <= A < 2048;
end

//
// painful debug stuff
//--------------fml--------------
//

reg [7:0] prev_opcode, opcode;
reg [9:0] opcode_addr, prev_opcode_addr;
reg breakfuck;
reg ded_3ded;

always @(posedge clk24)
begin
    if (~SYS_RESETN)
        ded_3ded <= 1'b0;

    breakfuck <= 0;


    if (cpu_m1 && cpu_ce)
    begin
        prev_opcode <= opcode;
        prev_opcode_addr <= opcode_addr;

        opcode <= DI;
        opcode_addr <= A[9:0];

        if (A == 16'h3ded)
            ded_3ded <= 1'b1;
    end
    if (prev_opcode == 8'hc2 && prev_opcode_addr == 10'h03ec && opcode != 8'h77)
        breakfuck <= 1;

end

//
//--------------fml--------------
//

assign DI=DI_;
reg[7:0] DI_;
always @*
 casex ({interrupt_ack,io_read,rom_access})
  3'b1xx:DI_<=8'hFF;
  3'b01x:DI_<=peripheral_data_in;
  3'b001:DI_<=ROM_DO;
  3'b000:DI_<=sram_data_in;
 endcase

 //---kvazwashere---
wire [15:0] address_bus = A;


`ifdef WITH_SDRAM
reg[31:0] rdvidreg;
always @(posedge clk24) rdvidreg={rdvidreg[30:0],rdvid};

assign DRAM_CLK=clk60;              //  SDRAM Clock
assign DRAM_CKE=1;                  //  SDRAM Clock Enable
wire[15:0] dramout,dramout2;
wire memcpubusy,memvidbusy,rdcpu_finished;
SDRAM_Controller ramd(
    .clk(clk60),                    //  Clock 60 MHz
    .reset(~RESET_n),               //  System reset
    .DRAM_DQ(DRAM_DQ),              //  SDRAM Data bus 16 Bits
    .DRAM_ADDR(DRAM_ADDR),          //  SDRAM Address bus 12 Bits
    .DRAM_LDQM(DRAM_LDQM),          //  SDRAM Low-byte Data Mask 
    .DRAM_UDQM(DRAM_UDQM),          //  SDRAM High-byte Data Mask
    .DRAM_WE_N(DRAM_WE_N),          //  SDRAM Write Enable
    .DRAM_CAS_N(DRAM_CAS_N),        //  SDRAM Column Address Strobe
    .DRAM_RAS_N(DRAM_RAS_N),        //  SDRAM Row Address Strobe
    .DRAM_CS_N(DRAM_CS_N),          //  SDRAM Chip Select
    .DRAM_BA_0(DRAM_BA_0),          //  SDRAM Bank Address 0
    .DRAM_BA_1(DRAM_BA_1),          //  SDRAM Bank Address 1
    .iaddr((rdvidreg[9])?{4'b0001,VIDEO_A[12:0],2'b00}:{ramdisk_addr,A[15],A[12:0],A[14:13]}),
    .idata(DO),
    .rd(ram_read&DBIN&~rom_access),
    .we_n(ram_write_n|io_write|WR_n), 
    .odata(dramout),                // [15:0] odata
    .odata2(dramout2),              // [15:0] odata2
    .memcpubusy(memcpubusy),
    .rdcpu_finished(rdcpu_finished),
    .memvidbusy(memvidbusy),
    .rdv(rdvidreg[9])
);
reg[7:0] sram_data_in;
always @(negedge rdcpu_finished) sram_data_in=dramout[7:0];

reg[31:0] vdata;
always @(negedge memvidbusy) vdata<={dramout2,dramout};

`elsif WITH_PSRAM

assign O_psram_reset_n = SYS_RESETN;

wire[15:0] dramout,dramout2;
wire psram_busy;
wire memcpubusy, memvidbusy, rdcpu_finished;

reg psram_rd_cpu;
always @(posedge clk24)
    psram_rd_cpu <= ram_read_pre;

wire psram_wr_cpu_pre = SYNC & ~(DO[1] | DO[4]); // unregistered raw_write_n and iowr
reg psram_wr_cpu;

always @(posedge clk24)
    `ifdef WITH_T8080
    if (ce3) psram_wr_cpu <= psram_wr_cpu_pre;
    `endif
    `ifdef WITH_VM80A
    if (ce3f2) psram_wr_cpu <= psram_wr_cpu_pre; //phi
    `endif

reg[63:0] rdvidreg;
always @(posedge clk_psram) rdvidreg={rdvidreg[62:0],rdvid};

`ifdef WITH_T8080
wire psram_rd_vid = rdvidreg[30]; 
`endif
`ifdef WITH_VM80A
wire psram_rd_vid = rdvidreg[33];
`endif


// -------- haltmode / romload write access -------------

wire [21:0] halt_addr;  // linear haltmode addr 

reg psram_busy_r; // psram_busy registered
reg halt_wr_r;    // haltmode/romload write request registered
reg halt_wr_cmd;  // psram command to write haltmode/romload data

reg [21:0] sideload_addr; // haltmode/romload addr selected
reg  [7:0] sideload_data; // haltmode/romload data selected
wire       sideload_halt; // merged halt_halt and romload_hold
assign     sideload_halt = halt_halt | romload_hold;

always @(posedge clk24)
begin
    if (!SYS_RESETN)
        {psram_busy_r, halt_wr_r, halt_wr_cmd} <= 3'b000;
    psram_busy_r <= psram_busy;

    halt_wr_cmd <= 1'b0;

    if (halt_wr | romload_wr)
    begin
        halt_wr_r <= 1'b1;

        sideload_addr <= halt_wr ? halt_addr : romload_addr;
        sideload_data <= halt_wr ? halt_data : romload_data;
    end

    if (halt_wr_r & psram_busy_r & ~psram_busy) // falling psram_busy
        {halt_wr_cmd, halt_wr_r} <= 2'b10;  // write cmd, clear reg
end

// -----------------------------------------------------


wire [21:0] sideload_addr_mangled = 
    {sideload_addr[21:16], sideload_addr[15],sideload_addr[12:0],sideload_addr[14:13]};

wire [21:0] cpu_a_mangled = {ramdisk_addr,A[15],A[12:0],A[14:13]};

wire [21:0] psram_addr = 
    sideload_halt ? sideload_addr_mangled :
    psram_rd_vid ? {4'b0001,VIDEO_A[12:0],2'b00} : cpu_a_mangled;

reg psram_rd_cpu_d, psram_wr_cpu_d;
always @(posedge clk_psram) begin
    psram_wr_cpu_d <= psram_wr_cpu;   // sample wr edge
    psram_rd_cpu_d <= psram_rd_cpu;   // sample rd edge
end

wire psram_rd_cpu_posedge = psram_rd_cpu & ~psram_rd_cpu_d;

wire psram_rd_cmd = psram_rd_cpu_posedge;// | psram_rd_vid; 
wire psram_wr_cmd = (psram_wr_cpu & ~psram_wr_cpu_d) | halt_wr_cmd;

wire [7:0] psram_di = halt_wr_cmd ? sideload_data : DO;

// this is almost an exact copy of CPU/STACK: 
// from the start of SYNC+STACK until SYNC without STACK
reg io_stack_long;
always @(posedge clk_psram)
begin
    if (io_stack_pre) io_stack_long <= 1'b1;
    if (SYNC & ~io_stack_pre) io_stack_long <= 1'b0;
end

wire [31:0] vdata;


`ifdef PSRAM_INTERNAL_VDATA
`else
reg[31:0] vdata_r;
assign vdata = vdata_r;

reg memvidbusy_r;
always @(negedge clk_psram)
begin
    memvidbusy_r <= memvidbusy;
    if (memvidbusy_r & ~memvidbusy) vdata_r <= {dramout2, dramout};
end
`endif

`ifdef PSRAM_INTERNAL_CPUBYTE
wire [7:0] sram_data_in;
`else
reg  [7:0] sram_data_in;
reg rdcpu_finished_r;
always @(negedge clk_psram)
begin
    rdcpu_finished_r <= rdcpu_finished;
    if (rdcpu_finished_r & ~rdcpu_finished)
        sram_data_in <= cpu_a_mangled[0] ? dramout[15:8] : dramout[7:0];
end
`endif

localparam PSRAM_FREQ = 72_000_000;
localparam PSRAM_LATENCY = 3;
PsramController #(
    .FREQ(PSRAM_FREQ),
    .LATENCY(PSRAM_LATENCY)
) mem_ctrl(
    .clk(clk_psram),
    .clk_p(clk_psram_p), 
    .resetn(SYS_RESETN), 
    .resetn_o(delayed_reset_n),     // psram controller dictates system reset
    .read(psram_rd_cmd),    // sampled edge (from cpu)
    .write(psram_wr_cmd),   // sampled edge (from cpu)
    .byte_write(1'b1),      // always bytes
    .rdv(psram_rd_vid),     // video access
    .addr(psram_addr), 
    .din({psram_di, psram_di}),
    .dout(dramout), 
    .dout2(dramout2), 
    .busy(psram_busy),

    .memcpubusy(memcpubusy),
    .memvidbusy(memvidbusy),
    .rdcpu_finished(rdcpu_finished),

    `ifdef PSRAM_INTERNAL_VDATA
    .vdata(vdata),
    `endif

    `ifdef PSRAM_INTERNAL_CPUBYTE
    .cpu_byte(sram_data_in),
    .cpu_byte_sel(cpu_a_mangled[0]),
    `endif

    // PSRAM i/o
    .O_psram_ck(O_psram_ck),
    .IO_psram_rwds(IO_psram_rwds), 
    .IO_psram_dq(IO_psram_dq),
    .O_psram_cs_n(O_psram_cs_n)
);

`else

// nothing
reg[31:0] vdata;
wire memcpubusy = 0, memvidbusy = 0, rdcpu_finished = 1;
reg[7:0] sram_data_in;

`endif

////////////////////
// 8x BARKAR KVAZ //
////////////////////

wire [5:0]  ramdisk_addr;

multikvaz mkvaz(
    .clk24(clk24),
    .clke(cpu_ce),
    .reset(mreset), 
    .address_r(address_bus_r), // registered bus for i/o ports
    .data(DO),
    .iowr(io_write & ~WR_n),

    .address(address_bus),    // proper addr bus for memory select logic
    .stack(io_stack_long),
    .ramdisk_addr(ramdisk_addr));


///////////
// VIDEO //
///////////
wire [7:0]  video_scroll_reg = vv55int_pa_out;
reg [7:0]   video_palette_value;
reg [3:0]   video_border_index;
reg         video_palette_wren;
reg         video_mode512;

wire [3:0] coloridx;
wire retrace;           // 1 == retrace in progress

wire vga_vs;
wire vga_hs;

wire video_lcd_clk;
wire video_lcd_den;
wire video_lcd_hsync;
wire video_lcd_vsync;

`ifdef WITH_TV
wire [1:0]      tv_mode = {~KEY[2], 1'b1};
`else
wire [1:0]      tv_mode = {2'b00};
`endif

wire        tv_sync;
wire [4:0]  tv_luma;
wire [4:0]  tv_chroma;
wire [4:0]  tv_cvbs;
wire [7:0]  tv_test;

wire[3:0] border_idx_delayed;
border_delay #(.DELAY(14)) bdly(.clk(clk24), .ce(ce6), .i_borderindex(video_border_index), .o_delayed(border_idx_delayed));

wire rdvid;
wire [7:0] realcolor;       // this truecolour value fetched from buffer directly to display
wire [7:0] realcolor2buf;   // this truecolour value goes into the scan doubler buffer

wire [14:0] bgr555;

video vidi(.clk24(clk24), 
            .ce12(ce12), 
            .ce6(ce6), 
            .ce6x(ce6x), 
            .clk4fsc(clkpal4FSC), 
            .reset_n(mreset_n),
            .video_slice(video_slice), 
            .pipe_ab(pipe_ab),
            .mode512(video_mode512), 
            .vdata(vdata),
            .SRAM_ADDR(VIDEO_A), 

            .hsync(vga_hs), .vsync(vga_vs),

            .lcd_hsync_o(video_lcd_hsync),        // lcd panel hsync (480 lines)
            .lcd_vsync_o(video_lcd_vsync),        // lcd panel vsync
            .lcd_clk_o(video_lcd_clk),
            .lcd_den_o(video_lcd_den), 

            .osd_hsync(osd_hsync), .osd_vsync(osd_vsync),
            .coloridx(coloridx),
            .realcolor_in(realcolor2buf),
            .realcolor_out(realcolor),      // TODO: add this line to other versions, it was lost!
            .bgr555_out(bgr555),            // same as realcolor_out but bgr555
            .retrace(retrace),
            .video_scroll_reg(video_scroll_reg),
`ifdef START1200
            .border_idx(4'b0),
`else
            .border_idx(border_idx_delayed),
`endif
                                
            .tv_sync(tv_sync),
            .tv_luma(tv_luma),
            .tv_chroma_o(tv_chroma),
            .tv_cvbs(tv_cvbs),
            .tv_test(tv_test),
            .tv_mode(tv_mode),
            .tv_osd_fg(osd_fg),
            .tv_osd_bg(osd_bg),
            .tv_osd_on(osd_active),
            .rdvid_o(rdvid)
            );

`ifdef START1200
wire[7:0] color1200;
palette_rom (
                       .address({video_mode512,video_border_index,retrace?4'b0:coloridx}), 
                       .clock(clk24),
                       .q(color1200));
assign {realcolor2buf[7:4],realcolor2buf[2:1],realcolor2buf[3],realcolor2buf[0]}={~color1200[5:0],2'b00};
`else

wire [3:0] paletteram_adr = (retrace/*|video_palette_wren*/) ? video_border_index : coloridx;

// simulate real Vector-06c K155RU2 (SN7489N)
// K155RU2 is asynchronous and remembers input value 
// for every address set while WR is active (0).
// Allegedly, real Vector-06c holds WR cycle for 
// approximately 3 pixel clocks
reg [3:0] palette_wr_sim;

always @(posedge clk24) begin
    if (iports_write & ~WR_n & cpu_ce) begin
        video_palette_value <= DO;
        palette_wr_sim <= 3;
    end 
    if (ce6 && |palette_wr_sim) palette_wr_sim <= palette_wr_sim - 1'b1;
end

always @*
    video_palette_wren <= |palette_wr_sim;

// delay palette_wren to match the real hw timings
reg [7:0] video_palette_wren_buf;
wire      video_palette_wren_delayed = video_palette_wren_buf[7];
always @(posedge clk24) begin
    if (ce12) video_palette_wren_buf <= {video_palette_wren_buf[6:0],video_palette_wren};
end

palette_ram ru2tru(
    .ad(paletteram_adr),              //input [3:0] ad
    .din(video_palette_value),        //input [7:0] din
    .dout(realcolor2buf),             //output [7:0] dout
    .clk(clk24),                      //input clk
    .oce(1'b1),                       //input oce
    .ce(1'b1),                        //input ce
    .reset(1'b0),                     //input reset
    .wre(video_palette_wren_delayed)  //input wre
);

`endif

wire [1:0]  lowcolor_b = {2{osd_active}} & {realcolor[7],1'b0};
wire        lowcolor_g = osd_active & realcolor[5];
wire        lowcolor_r = osd_active & realcolor[2];

wire [7:0]  overlayed_colour = osd_active ? osd_colour : realcolor;

reg [3:0] video_r;
reg [3:0] video_g;
reg [3:0] video_b;

always @(posedge clk24) begin
    video_r <= {overlayed_colour[2:0], lowcolor_r};
    video_g <= {overlayed_colour[5:3], lowcolor_g};
    video_b <= {overlayed_colour[7:6], lowcolor_b};
end

`ifdef VIDEOMOD
videomod videomod(.clk_color_mod(clk_color_mod),
    .video_r(video_r), .video_g(video_g), .video_b(video_b),
    .vga_hs(vga_hs), .vga_vs(vga_vs),
    .lcd_clk_i(video_lcd_clk), .lcd_den_i(video_lcd_den),
    .lcd_clk_o(LCD_CLK), .lcd_den_o(LCD_DEN),
    .tv_cvbs(tv_cvbs), .tv_luma(tv_luma), .tv_chroma(tv_chroma),
    .VGA_HS(LCD_HSYNC), .VGA_VS(LCD_VSYNC),
    .VGA_R(LCD_R[4:1]), .VGA_G(LCD_G[5:2]), .VGA_B(LCD_B[4:1]),
    .S_VIDEO_Y(LCD_G[0]), .S_VIDEO_C(LCD_G[1]));
`else

wire [14:0] osd_555 = bgr233to555(osd_colour);
wire [14:0] overlayed_bgr555 = osd_active ? osd_555 : bgr555;

`ifdef WITH_LCD

// the purpose of this part is to produce the blackest picture we can for
// a brief moment after powering up to literally clear the tft matrix
wire goth_den, goth_hs, goth_vs;

VGAMod gothvideo
  (.CLK(clk24),
   .nRST(1),
   .PixelClk(clk24),
   .LCD_DE(goth_den),
   .LCD_HSYNC(goth_hs),
   .LCD_VSYNC(goth_vs));

reg goth_vs_r;
reg vanilla = 1'b0;
reg [3:0] goth_counter = 4'b0;

always @(posedge clk24)
begin
    if (!vanilla)
    begin
        goth_vs_r <= goth_vs;
        if (goth_vs_r & ~goth_vs) 
        begin
            goth_counter <= goth_counter + 1'b1;
            vanilla <= &goth_counter;
        end
    end
end

assign LCD_CLK =    video_lcd_clk;
assign LCD_DEN =    vanilla ? video_lcd_den : goth_den;
`ifdef SCAN_7INCH
assign LCD_HSYNC =  vanilla ? video_lcd_hsync : goth_hs;
assign LCD_VSYNC =  vanilla ? video_lcd_vsync : goth_vs;
`else
assign LCD_HSYNC =  vanilla ? vga_hs : goth_hs;
assign LCD_VSYNC =  vanilla ? vga_vs : goth_vs;
`endif
// FIX this for OSD!
//assign LCD_R[4:1] = video_r;
//assign LCD_G[5:2] = video_g;
//assign LCD_B[4:1] = video_b;

assign LCD_R[4:0] = vanilla ? overlayed_bgr555[4:0]   : 5'd0;
assign LCD_G[5:1] = vanilla ? overlayed_bgr555[9:5]   : 5'd0;
assign LCD_B[4:0] = vanilla ? overlayed_bgr555[14:10] : 5'd0;

`endif

`endif // WITH_LCD

///////////
// RST38 //
///////////

// Retrace irq delay:
wire int_delay;
reg int_request;
wire int_rq_tick;
reg  int_rq_hist;


///////////////////////////////
// MULTICOLOR FINE ADJUST
///////////////////////////////

//oneshot #(10'd28) retrace_delay(clk24, cpu_ce, retrace, int_delay);
// 21 too early, 22 almost too good, 23-24 good
oneshot #(10'd25) retrace_delay(clk24, cpu_ce, retrace, int_delay); 
oneshot #(10'd191) retrace_irq(clk24, cpu_ce, ~int_delay, int_rq_tick);

always @(posedge clk24) begin
    int_rq_hist <= int_rq_tick;
    
    if (~int_rq_hist & int_rq_tick & INTE) 
        int_request <= 1;
    
    if (interrupt_ack)
        int_request <= 0;
end


///////////////////
// PS/2 KEYBOARD //
///////////////////
reg         kbd_mod_rus;
wire [7:0]  kbd_rowbits;
wire        kbd_key_shift;
wire        kbd_key_ctrl;
wire        kbd_key_rus;
wire        kbd_key_blksbr;
wire        kbd_key_blkvvod = kbd_key_blkvvod_phy | osd_command_f11 | halt_command_f11;
wire        kbd_key_blkvvod_phy;
wire        kbd_key_scrolllock;
wire [5:0]  kbd_keys_osd;

`ifdef WITH_KEYBOARD

    wire [7:0]  kbd_rowselect = ~vv55int_pa_out;
    
    `ifdef WITH_KEYBOARD_HID
    wire [7:0] uarthid_debug;

    // keyboard via HID to serial adapter
    uarthid uarthid1(
        .clk(clk24),
        .reset(~delayed_reset_n),
        .uart_rx(HID_UART_RX),
        .i_rowselect(kbd_rowselect),
        .o_rowbits(kbd_rowbits),
    
        .i_mod_rus(kbd_mod_rus), 
    
        .o_key_shift(kbd_key_shift), 
        .o_key_ctrl(kbd_key_ctrl), 
        .o_key_rus(kbd_key_rus), 
        .o_key_blksbr(kbd_key_blksbr), 
        .o_key_blkvvod(kbd_key_blkvvod_phy),
        .o_key_bushold(kbd_key_scrolllock),
        .o_key_osd(kbd_keys_osd),
        .i_osd_active(scrollock_osd),
        .o_debug(uarthid_debug)
    );

    //always @(posedge clk24)
    //    LED[5:0] <= uarthid_debug[5:0];//{kbd_key_shift,kbd_key_ctrl,kbd_key_rus,kbd_key_blkvvod_phy,kbd_key_blksbr,kbd_keys_osd};
    `endif
    
    `ifndef WITH_KEYBOARD_PS2
    wire PS2_CLK = 1'b1;
    wire PS2_DAT = 1'b1;
    `endif
    
    `ifdef WITH_KEYBOARD_SERIAL
    // keyboard via serial debug console
    vectorkeys kbdmatrix(
        .clkk(clk24), 
        //.reset(~SYS_RESETN), 
        .reset(~delayed_reset_n),
        .ps2_clk(PS2_CLK), 
        .ps2_dat(PS2_DAT), 
        .ext_scancode_i(halt_scancode),
        .ext_scancode_ready_i(halt_scancode_ready),
        .mod_rus(kbd_mod_rus), 
        .rowselect(kbd_rowselect), 
        .rowbits(kbd_rowbits), 
        .key_shift(kbd_key_shift), 
        .key_ctrl(kbd_key_ctrl), 
        .key_rus(kbd_key_rus), 
        .key_blksbr(kbd_key_blksbr), 
        .key_blkvvod(kbd_key_blkvvod_phy),
        .key_bushold(kbd_key_scrolllock),
        .key_osd(kbd_keys_osd),
        .osd_active(scrollock_osd)
        );
    `endif

`else
// no keyboard of any kind
    assign kbd_rowbits = 8'hff;
    assign kbd_key_shift = 0;
    assign kbd_key_ctrl = 0;
    assign kbd_key_rus = 0;
    assign kbd_key_blksbr = 0;
    assign kbd_key_blkvvod_phy = 0;
    assign kbd_key_scrolllock = 0;
`endif


///////////////
// I/O PORTS //
///////////////

reg [7:0] peripheral_data_in;

// Priority encoder is a poor choice for bus selector, see case below, works much better
//
//always peripheral_data_in = ~vv55int_oe_n ? vv55int_odata :
//                          vi53_rden ? vi53_odata : 
//                          floppy_rden ? floppy_odata : 
//                          ~vv55pu_oe_n ? vv55pu_odata : 8'hFF;
always @*
    case ({ay_rden, ~vv55int_oe_n, vi53_rden, floppy_rden, vv55pu_rden}) 
        5'b10000: peripheral_data_in <= ay_odata;
        5'b01000: peripheral_data_in <= vv55int_odata;
        5'b00100: peripheral_data_in <= vi53_odata;
        5'b00010: peripheral_data_in <= floppy_odata;
        5'b00001: peripheral_data_in <= vv55pu_odata;
        default: peripheral_data_in <= 8'hFF;
    endcase

// Devices:
//   000xxxYY [a7:a0]
//      000: internal VV55
//      001: external VV55 (PU)
//      010: VI53 interval timer
//      011: internal:  00: palette data out
//                      01-11: joystick inputs
//      100: ramdisk bank switching
//      101: AY-3-8910, ports 14, 15 (00, 01)
//      110: FDC ($18-$1B)
//      111: FDC ($1C, secondary control reg)

reg [5:0] portmap_device;               
always @* portmap_device = address_bus_r[7:2];



///////////////////////
// vv55 #1, internal //
///////////////////////

wire        vv55int_sel = portmap_device == 3'b000;

wire [1:0]  vv55int_addr =  ~address_bus_r[1:0];
wire [7:0]  vv55int_idata = DO; 
wire [7:0]  vv55int_odata;
wire        vv55int_oe_n;

wire vv55int_cs_n = !(/*~ram_write_n &*/ (io_read | io_write) & vv55int_sel);
wire vv55int_rd_n = ~io_read;//~DBIN;
wire vv55int_wr_n = WR_n | ~cpu_ce;

reg [7:0]   vv55int_pa_in;
reg [7:0]   vv55int_pb_in;
reg [7:0]   vv55int_pc_in;

wire [7:0]  vv55int_pa_out;
wire [7:0]  vv55int_pb_out;
wire [7:0]  vv55int_pc_out;


`ifdef OLD_82C55
wire vv55int_pa_oe_n;
wire vv55int_pb_oe_n;
wire vv55int_pc_oe_n;

I82C55 vv55int(
    vv55int_addr,
    vv55int_idata,
    vv55int_odata,
    vv55int_oe_n,
    
    vv55int_cs_n,
    vv55int_rd_n,
    vv55int_wr_n,
    
    vv55int_pa_in,
    vv55int_pa_out,
    vv55int_pa_oe_n,                // enable always
    
    vv55int_pb_in,                  // see keyboard
    vv55int_pb_out,
    vv55int_pb_oe_n,                // enable always
    
    vv55int_pc_in,
    vv55int_pc_out,
    vv55int_pc_oe_n,                // enable always
    
    mreset,     // active 1
    
    cpu_ce,
    clk24);
`else
assign vv55int_oe_n = vv55int_cs_n;
k580vv55 vv55int(
    .reset(mreset),
    .clk_sys(clk24),
    .addr(vv55int_addr),
    .we_n(vv55int_wr_n | vv55int_cs_n),
    .idata(vv55int_idata),
    .odata(vv55int_odata),
    .ipa(vv55int_pa_in),
    .opa(vv55int_pa_out),
    .ipb(vv55int_pb_in),
    .opb(vv55int_pb_out),
    .ipc(vv55int_pc_in),
    .opc(vv55int_pc_out));

`endif

always @(posedge clk24) begin
    // port B
    video_border_index <= vv55int_pb_out[3:0];  // == palette address for out $0C

`ifdef WITH_CPU
    video_mode512 <= vv55int_pb_out[4];
`else
    video_mode512 <= 1'b0;
`endif
    // port C
    gledreg[9] <= vv55int_pc_out[3];        // RUS/LAT LED
end 

always @(kbd_rowbits) vv55int_pb_in <= ~kbd_rowbits;
always @(kbd_key_shift or kbd_key_ctrl or kbd_key_rus) begin
    vv55int_pc_in[5] <= ~kbd_key_shift;
    vv55int_pc_in[6] <= ~kbd_key_ctrl;
    vv55int_pc_in[7] <= ~kbd_key_rus;
end

always @*
    vv55int_pc_in[4] <= ~tape_input_wav; //tape_input ^ tape_input_wav;

always @* vv55int_pc_in[3:0] <= 4'b1111;


///////////////////////
// vv55 #2, PU       //
///////////////////////

wire        vv55pu_sel = portmap_device == 3'b001;

wire [1:0]  vv55pu_addr =   ~address_bus_r[1:0];
wire [7:0]  vv55pu_idata = DO;  
wire [7:0]  vv55pu_odata;
wire        vv55pu_oe_n;

wire vv55pu_cs_n = !(/*~ram_write_n &*/ (io_read | io_write) & vv55pu_sel);
wire vv55pu_rd_n = ~io_read;//~DBIN;
wire vv55pu_wr_n = WR_n | ~cpu_ce;
wire vv55pu_rden = io_read & vv55pu_sel;

reg [7:0]   vv55pu_pa_in;
reg [7:0]   vv55pu_pb_in;
reg [7:0]   vv55pu_pc_in;

wire [7:0]  vv55pu_pa_out;
wire [7:0]  vv55pu_pb_out;
wire [7:0]  vv55pu_pc_out;

wire vv55pu_pa_oe_n;
wire vv55pu_pb_oe_n;
wire vv55pu_pc_oe_n;

I82C55 vv55pu(
    vv55pu_addr,
    vv55pu_idata,
    vv55pu_odata,
    vv55pu_oe_n,

    vv55pu_cs_n,
    vv55pu_rd_n,
    vv55pu_wr_n,

    vv55pu_pa_in,
    vv55pu_pa_out,
    vv55pu_pa_oe_n,

    vv55pu_pb_in,
    vv55pu_pb_out,
    vv55pu_pb_oe_n,

    vv55pu_pc_in,
    vv55pu_pc_out,
    vv55pu_pc_oe_n,

    mreset,     // active 1

    cpu_ce,
    clk24);

reg[7:0]    RSdataIn,RSctrl;
wire[7:0]   RSdataOut;
always @(posedge clk24) begin
    CovoxData <= vv55pu_pa_out;
    RSdataIn <= vv55pu_pb_out;
    RSctrl <= vv55pu_pc_out;
    vv55pu_pb_in <= RSdataOut;
end


////////////////////////////////
// 580VI53 timer: ports 08-0B //
////////////////////////////////
wire            vi53_sel = portmap_device == 3'b010;
//wire            vi53_wren = ~WR_n & io_write & vi53_sel; 
wire            vi53_wren = ~wrn_sampled & io_write & vi53_sel; 
wire            vi53_rden = io_read & vi53_sel;
wire    [7:0]   vi53_odata;


`ifdef WITH_VI53
    `ifdef VI53_SVOFSKI
pit8253 vi53(
            .clk(clk24), 
            .ce(cpu_ce), 
            .tce(vi53_timer_ce), 
            .a(~address_bus_r[1:0]), 
            .wr(vi53_wren), 
            .rd(vi53_rden), 
            .din(DO),
            .dout(vi53_odata), 
            .gate(3'b111), 
            .out(vi53_out));
    `endif
    `ifdef VI53_B2M
k580wi53 wi53(.clk(clk24),
	.c0(cpu_ce), .c1(cpu_ce), .c2(cpu_ce),
    .g0(1), .g1(1), .g2(2),
    .out0(vi53_out[0]), .out1(vi53_out[1]), .out2(vi53_out[2]),
    .addr(~address_bus_r[1:0]),
    .rd(vi53_rden),
    .we_n(~vi53_wren),
    .idata(DO),
    .odata(vi53_odata));
    `endif
    `ifdef VI53_SORGELIG
k580vi53 vi53s(
	// CPU bus
    .reset(mreset),
    .clk_sys(clk24),
    .addr(~address_bus_r[1:0]),
    .din(DO),
    .dout(vi53_odata),
    .wr(vi53_wren),
    .rd(vi53_rden),
	// Timer signals
    .clk_timer({3{vi53_timer_ce}}),
    .gate(3'b111),
    .out(vi53_out));
    `endif
`else
assign vi53_out = 3'b000;
assign vi53_odata = 8'h00;
`endif


////////////////////////////
// Internal ports, $0C -- //
////////////////////////////
wire        iports_sel      = portmap_device == 3'b011;
wire        iports_write    = /*~ram_write_n &*/ io_write & iports_sel; // this repeats as a series of 3 _|||_ wtf

// port $0C-$0F: palette value out
wire iports_palette_sel = address_bus[1:0] == 2'b00;        // not used <- must be fixed some day


//////////////////////////////////
// Floppy Disk Controller ports //
//////////////////////////////////

wire [7:0]  osd_command;

wire        osd_command_bushold = osd_command[0];
wire        osd_command_f12     = osd_command[1];
wire        osd_command_f11     = osd_command[2];
//                                osd_command[3] -> romload_hold
wire        floppy_sel = portmap_device[2:1] == 2'b11; // both 110 and 111

//--------------------------------------------------------------
// WR_n may hold for 2 cpu_ce cycles, I'm not sure why
// to avoid double-writes, we sample WR_n to detect negedge WR_n
// this will also likely cause problems with other peripherals
reg wrn_sampled_r;
always @(posedge clk24)
    if (cpu_ce)
        wrn_sampled_r <= WR_n;
wire wrn_sampled = ~(wrn_sampled_r & ~WR_n);

wire        floppy_wren = ~wrn_sampled & io_write & floppy_sel;
//--------------------------------------------------------------

wire        floppy_rden  = io_read & floppy_sel;

wire        floppy_death_by_floppy;

wire floppy_uart_tx_wr;
wire [7:0] floppy_uart_tx_data;

// ---------- ROM / EDD file loader signals ------------
wire         romload_hold;  // pauses the CPU (maybe even video)
wire  [15:0] romload_addr;  // write address
wire   [5:0] romload_page;  // kvaz page, 0 = main ram
wire   [7:0] romload_data;  // write data
wire         romload_wr;    // write command


`ifdef WITH_FLOPPY
wire [7:0]  floppy_odata;
wire [7:0]  wav_sample;

assign tape_input_wav = wav_sample[7];

//floppy_zpu_avalanche floppy_za(
floppy_neo430 floppy_neo(
    .clk(clk24), 
    .cpu_ce(cpu_ce),  
    //.reset_n(KEY[0]),       // to make it possible to change a floppy image, then press F11
    .reset_n(SYS_RESETN),
    
    // sd card signals
    .sd_dat(SD_DAT), 
    .sd_dat3(SD_DAT3), 
    .sd_cmd(SD_CMD), 
    .sd_clk(SD_CLK), 
    
    // uart comms
    .o_uart_send(floppy_uart_tx_wr),
    .o_uart_data(floppy_uart_tx_data),
    .i_uart_busy(uart_tx_busy),

    // io ports
    .hostio_addr({address_bus_r[2],~address_bus_r[1:0]}),
    .hostio_idata(DO),
    .hostio_odata(floppy_odata),
    .hostio_rd(floppy_rden),
    .hostio_wr(floppy_wren),
    
    // screen memory
    .o_osd_addr(osd_addr),
    .o_osd_data(osd_data),
    .o_osd_rden(osd_rden),
    .o_osd_wren(osd_wren),
    .i_osd_data(osd_q),
    
    .keyboard_keys(kbd_keys_osd),
    
    .osd_command(osd_command),

    .o_rom_hold(romload_hold),
    .o_rom_addr(romload_addr),
    .o_rom_page(romload_page),
    .o_rom_data(romload_data),
    .o_rom_wr  (romload_wr),

    .o_wav_sample(wav_sample),
    
    // debug 
    .host_hold(floppy_death_by_floppy)
    );


`else 
assign floppy_death_by_floppy = 1'b0;
wire [7:0]  floppy_odata = 
`ifdef FLOPPYLESS_HAX
    8'h00;
`else
    8'hFF;
`endif  
wire [7:0]  floppy_status = 8'hff;

assign romload_hold = 0;
assign romload_addr = 0;
assign romload_page = 0;
assign romload_data = 0;
assign romload_wr   = 0;
assign tape_input_wav = 0;
`endif



///////////////////////
// On-Screen Display //
///////////////////////
wire            osd_hsync, osd_vsync;   // provided by video.v
reg             osd_active;
reg [7:0]       osd_colour;
always @(posedge clk24)
    if (scrollock_osd & osd_bg)
    begin
        osd_active <= 1;
        osd_colour <= osd_fg ? 8'b11111110 : 8'b01011001;   // slightly greenish tint hopefully
    end 
    else 
        osd_active <= 0;

wire            osd_fg;
wire            osd_bg;
wire [1:0]      osd_wren;   // wren byte select
wire            osd_rden;   // always read words
wire [15:0]     osd_data;
wire [15:0]     osd_rq;
wire [7:0]      osd_addr;

wire [15:0]     osd_q;

wire [7:0] osd_ql = osd_rq[7:0] + 8'd32;
wire [7:0] osd_qh = osd_rq[15:8] + 8'd32;

assign osd_q = {osd_qh, osd_ql};

// OSD encoding has 00 == 32
wire [7:0] osd_datah = osd_data[15:8] - 8'd32;
wire [7:0] osd_datal = osd_data[7:0] - 8'd32;

`ifdef WITH_OSD
textmode osd(
    .clk(clk24),
    .ce(ce12),          // ce12 for wide text
    .vsync(osd_vsync),
    .hsync(osd_hsync),
    .pixel(osd_fg),
    .background(osd_bg),
    // -- cpu interface --
    .osd_addr(osd_addr),
    .osd_data({osd_datah, osd_datal}),
    .osd_wren(osd_wren),
    .osd_rden(osd_rden),
    .osd_q(osd_rq)
    );
`else
assign osd_fg = 0;
assign osd_bg = 0;
assign osd_rq  = 0;
`endif

////////
// AY //
////////
wire [7:0]  ay_odata;
wire        ay_rden;
wire        ay_wren;
wire        ay_sel;

`ifdef WITH_AY
assign      ay_sel = portmap_device == 3'b101 && address_bus_r[1] == 0; // only ports $14 and $15
assign      ay_wren = ~WR_n & io_write & ay_sel;
assign      ay_rden = io_read & ay_sel;

reg [3:0] aycectr;
always @(posedge clk24) if (aycectr<14) aycectr <= aycectr + 1'd1; else aycectr <= 0;

ayglue shrieker(
                .clk(clk24),
                .ce(aycectr == 0),
                .reset_n(mreset_n), 
                .address(address_bus_r[0]),
                .data(DO), 
                .q(ay_odata),
                .wren(ay_wren),
                .rden(ay_rden),
                .soundA(ay_soundA),
                .soundB(ay_soundB),
                .soundC(ay_soundC)
                );              
`else
assign ay_soundA=8'b0;
assign ay_soundB=8'b0;
assign ay_soundC=8'b0;
assign ay_rden = 1'b0;
assign ay_odata = 8'hFF;
`endif

`ifdef WITH_RSOUND

ym2149 rsound(
    .DI(RSdataIn),
    .DO(RSdataOut),
    .BDIR(RSctrl[2]), 
    .BC(RSctrl[1]),
    .OUT_A(rs_soundA),
    .OUT_B(rs_soundB),
    .OUT_C(rs_soundC),
    .CS(1'b1),
    .ENA(aycectr == 0),
    .RESET(RSctrl[3]|~mreset_n),
    .CLK(clk24)
    );                
`else
assign rs_soundA=8'b0;
assign rs_soundB=8'b0;
assign rs_soundC=8'b0;
assign RSdataOut = 8'b0;
`endif

// button debounce

//wire button_debounced;
//oneshot #(16'hffff) button_debounce(clk24, cpu_ce, ~BUTTON, button_debounced);
reg [23:0] debounce_ctr;
reg        debounce_on;
reg        button_debounced;
always @(posedge clk24)
begin
    if (~SYS_RESETN)
        {debounce_on, button_debounced} <= 2'b00;
    else
    if (vi53_timer_ce) begin
      button_debounced <= 1'b0;
      if (!debounce_on)
      begin
          if (~BUTTON)
          begin
              debounce_ctr <= 24'hffffff;
              debounce_on <= 1'b1;
              button_debounced <= 1'b1;
          end
      end
      else
      begin
          debounce_ctr <= debounce_ctr - 1'b1;
          if (debounce_ctr == 0)
              debounce_on <= 1'b0;
      end
    end
end

//////////////////
// Special keys //
//////////////////

wire    scrollock_osd;
wire    blksbr_reset_pulse;
wire    disable_rom;

wire    halt_command_f12;
wire    halt_command_f11;

specialkeys skeys(
                .clk(clk24), 
                .cpu_ce(cpu_ce),
                .reset_n(mreset_n), 
                .key_blksbr(button_debounced || kbd_key_blksbr == 1'b1 || osd_command_f12 || halt_command_f12), 
                .key_osd(kbd_key_scrolllock),
                .o_disable_rom(disable_rom),
                .o_blksbr_reset(blksbr_reset_pulse),
                .o_osd(scrollock_osd)
                );
                
always @* gledreg[8] <= disable_rom;               

`ifdef WITH_I2C
I2C_AV_Config       u7(clk24,mreset_n,I2C_SCLK,I2C_SDAT);
`endif

wire [7:0] halt_data;
wire halt_wr;
wire halt_halt;
wire [11:0] halt_fkeys;

wire [7:0] halt_scancode;
wire halt_scancode_ready;

wire [7:0] halt_uart_tx_data;
wire halt_uart_tx_wr;

//////////////////// UART TX /////////////////////////
wire [7:0] uart_tx_data = floppy_uart_tx_wr ? floppy_uart_tx_data : halt_uart_tx_data;
wire uart_tx_wr = halt_uart_tx_wr | floppy_uart_tx_wr;
wire uart_tx_busy;
wire uart_tx1;
uart_tx_V2 tx(
    .clk(clk24),
    .din(uart_tx_data),
    .wr_en(uart_tx_wr),
    .tx_busy(uart_tx_busy), 
    .tx_p(uart_tx1));

assign UART_TX = uart_tx1 & HID_UART_RX;

defparam tx.uart_freq=115200;
defparam tx.clk_freq=24_000_000;

`ifdef WITH_SERIAL_PROBE

assign halt_command_f11 = halt_fkeys[10];
assign halt_command_f12 = halt_fkeys[11];

haltmode debugger(.clk24(clk24), .rst_n(delayed_reset_n),
    .uart_rx(UART_RX),
    .o_uart_tx_data(halt_uart_tx_data),
    .o_uart_tx_wr(halt_uart_tx_wr),
    .i_uart_tx_busy(uart_tx_busy),
    .addr_o(halt_addr), .data_o(halt_data), .wr_o(halt_wr),
    .halt_o(halt_halt),
    .fkeys_o(halt_fkeys),
    .scancode_o(halt_scancode),
    .scancode_ready_o(halt_scancode_ready)
);

//always @(posedge clk24)
//    LED[5:0] <= {cpu_m1, ~halt_addr[4:0]};

`else

assign halt_addr = 22'h0;
assign halt_data = 8'h00;
assign halt_wr = 1'b0;
assign halt_halt = 1'b0;
assign halt_fkeys = 12'b0;

assign halt_uart_tx_data = 8'h00;

assign halt_scancode = 8'h00;
assign halt_scancode_ready = 1'b0;

assign halt_uart_tx_wr = 1'b0;

`endif

`ifdef WITH_HDMI

wire [23:0] overlayed_rgb24 = {overlayed_bgr555[4:0],3'b0,
    overlayed_bgr555[9:5],3'b0,
    overlayed_bgr555[14:10],3'b0};

reg [23:0] rgb = 24'd0;
wire [9:0] hdmi_cx, hdmi_cy;
wire [9:0] frame_width, frame_height, screen_width, screen_height;
// Border test (left = red, top = green, right = blue, bottom = blue, fill = black)
always @(posedge clk24)
  rgb <= 
    //{cx < 16 ? ~8'd0 : 8'd0, cy < 16 ? ~8'd0 : 8'd0, cx >= screen_width - 16 || cy >= screen_height - 16 ? ~8'd0 : 8'd0} ^ 
    overlayed_rgb24;

`ifdef WITH_HDMI_AUDIO
reg [15:0] unpacked_audio_sample[0:1];
always @* //(posedge clk24)
begin
    unpacked_audio_sample[0] <= hdmi_audio_sample[15:0];
    unpacked_audio_sample[1] <= hdmi_audio_sample[31:16];
end
`endif

// 752x576 (768x624) 50Hz 
hdmi #(.VIDEO_ID_CODE(18),
       .VIDEO_REFRESH_RATE(50),
       .AUDIO_RATE(48000),
       .AUDIO_BIT_WIDTH(16)
       `ifndef WITH_HDMI_AUDIO
       ,
       .START_X(620),
       .START_Y(196)
       `endif
       )
  hdmi(
  .clk_pixel_x5(clk_p5),
  .clk_pixel(clk24),
  .reset(~SYS_RESETN),
  .rgb(rgb),

  `ifdef WITH_HDMI_AUDIO
  .clk_audio(hdmi_audio_clk),
  .audio_sample_word(unpacked_audio_sample),
  `endif

  .tmds_clk_n(tmds_clk_n),
  .tmds_clk_p(tmds_clk_p),
  .tmds_d_n(tmds_d_n),
  .tmds_d_p(tmds_d_p),
  .cx(hdmi_cx),
  .cy(hdmi_cy),
  .frame_width(frame_width),
  .frame_height(frame_height),
  .screen_width(screen_width),
  .screen_height(screen_height)
);

`endif


endmodule
