svofski/vector06cc/firmware/floppysrc_neo430/menu.c

// ====================================================================
//                       VECTOR-06C FPGA REPLICA
//
//               Copyright (C) 2007-2024 Viacheslav Slavinsky
//
// This code is distributed under modified BSD license. 
// For complete licensing information see LICENSE.TXT.
// -------------------------------------------------------------------- 
//
// An open implementation of Vector-06C home computer
//
// Author: Viacheslav Slavinsky, https://caglrc.cc
// 
// Source file: menu.c
//
// Menu functions
//
// --------------------------------------------------------------------

#include "integer.h"
#include "specialio.h"
#include "osd.h"
#include "menu.h"
#include "philes.h"
#include "serial.h"
#include "timer.h"
#include "rstrings.h"

#include <string.h>
#ifdef SIMULATION
#include <assert.h>
#endif


extern uint8_t* dmem;
extern char* ptrfile;

static int32_t fsel_pagestart;  // start refresh from here
//static uint8_t fsel_redraw;     // plz redraw file selector, teh slow
static uint8_t fsel_hasnextpage; 

#define INVALID_VIEW   1
#define INVALID_FSEL   2        // this is only for files, menu has its own selection

static uint8_t invalid;
static uint8_t joy_status;

#define STATE_MENU              0
#define STATE_FSEL              1
#define STATE_WAITBREAK         10
#define STATE_FILESELECTED      11
#define STATE_ABOOT2            12
#define STATE_ABOOT             2

static uint8_t state = 0377;

static char* menu_item[] = {    NULL,           TXT_MENU_UP,      NULL,
                                TXT_MENU_LEFT,  TXT_MENU_MIDDLE,  TXT_MENU_RIGHT,
                                NULL,           TXT_MENU_DOWN,    NULL};

#ifndef SIMULATION
static 
#endif
int8_t menu_x, menu_y, menu_selected;

static uint8_t osdcmd = 0;

#define INACTIVITY 65535U //8192

static uint16_t inactivity;

#define SEL_HOLD        1
#define SEL_RESET       3
#define SEL_DISK        4
#define SEL_RESTART     5
#define SEL_ABOUT       7


#define FSEL_PAGESIZE   12              // total of 12 items
#define FSEL_NLINES     6               // 6 lines

uint8_t dude_seqno;

typedef struct _tui_page {
    int32_t page_start;
    uint8_t sel_x, sel_y;
    file_kind_t filter;
} tui_page_t;

#define N_PAGES (1 + 5)
tui_page_t pages[N_PAGES];        // menu, fdd, rom, edd, cas, wav
int8_t current_page;              // current page
int8_t return_to_page;
#define PAGE_FSEL_FIRST 1         // first page (FDD)
#define PAGE_FSEL_LAST  5         // last page (WAV)

static void switch_state(void);
static void draw_fsel_page(void);
static void draw_fsel(void);
static void fsel_showselection(uint8_t on);
static void fsel_getselected(char *file);
void aboot_anim(void);
void aboot_show(void);

void menu_goto_page(int page);
void init_pages();
void save_page_state(int page);

static void invalidate()
{
    invalid |= INVALID_VIEW;
}

static void invalidate_fsel()
{
    invalid |= INVALID_FSEL;
}

uint8_t menu_busy(uint8_t status) {
#if 0
    char *text;

    switch (status) {
        case 0: text = state == STATE_ABOOT2 ? TXT_MENU_ABOOTHALP : TXT_MENU_HALP;
                break;
        case 1: text = TXT_MENU_BUSY;
                break;
        case 2: text = TXT_MENU_INSERT;
                menu_init();
                break;
    }
    osd_gotoxy(0, 7);
    osd_puts(text);
#endif
    return 0;
}

int is_empty(int x, int y)
{
    static char tmpname[8+3+1+1];

    int8_t save_selected = menu_selected;
    menu_selected = x + y * 2;
    fsel_getselected(tmpname);
    menu_selected = save_selected;
    return tmpname[0] == 0 || tmpname[0] == '<'; // <NO FILES>
}

int check_move(int newx, int newy)
{
    if (newx < 0) {
        return 0;
    }
    if (newx > 1) {
        return 0;
    }
    if (newy < 0) {
        return 0;
    }
    if (newy > FSEL_NLINES-1) {
        return 0;
    }
    if (is_empty(newx, newy)) {
        return 0;
    }

    return 1;
}

int find_last_good()
{
    int y = FSEL_NLINES - 1;
    while (y >= 0) {
        if (!is_empty(0, y)) return y;
        --y;
    }
    return -1;
}

void adjust_fsel()
{
    while (is_empty(menu_x, menu_y) && menu_y > 0) {
        --menu_y;
    }
    if (is_empty(menu_x, menu_y)) {
        menu_x = 0;
    }
}

// return MENURESULT_DISK etc.. when something is selected
uint8_t menu_dispatch(uint8_t tick) {
    uint8_t result = MENURESULT_NOTHING;

    if (tick && (state == STATE_ABOOT2)) {
        aboot_anim(); 
    }

    if (inactivity) inactivity--;
    if (!inactivity && state == STATE_FSEL) {
        menu_init();
    }

    if (JOYSTICK != joy_status) {
        joy_status = JOYSTICK;

        inactivity = INACTIVITY;

        switch (state) {
            case STATE_ABOOT:
                if (joy_status == 0) {
                    state = STATE_ABOOT2;
                }
                break;

            case STATE_MENU:
                if (joy_status & JOY_UP)
                    menu_y = 0;
                else if (joy_status & JOY_DN)
                    menu_y = 2;
                else
                    menu_y = 1;

                if (joy_status & JOY_LT)
                    menu_x = 0;
                else if (joy_status & JOY_RT)
                    menu_x = 2;
                else
                    menu_x = 1;

                invalidate();

                if (joy_status & JOY_FIRE) {
                    state = STATE_WAITBREAK;
                    menu_selected = menu_x+menu_y*3;
                }
                break;

            case STATE_WAITBREAK:
                if (!(joy_status & JOY_FIRE)) {
                    switch_state();
                }
                break;

            case STATE_FILESELECTED:
                if (!(joy_status & JOY_FIRE)) {
                    fsel_getselected(ptrfile + 10);
                    ser_puts("Selected image: "); ser_puts(ptrfile); ser_nl();
                    menu_goto_page(0);
                    result = MENURESULT_DISK;
                }
                break;

            case STATE_ABOOT2:
                if (!(joy_status & JOY_FIRE)) {
                    menu_goto_page(0);
                }
                break;

            case STATE_FSEL:
                if (joy_status & JOY_UP) {
                    if (check_move(menu_x, menu_y - 1)) {
                        menu_y -= 1;
                    }
                    else {
                        fsel_pagestart -= FSEL_PAGESIZE - 2;
                        menu_y = FSEL_NLINES - 1;
                        invalidate();
                    }
                } 

                if (joy_status & JOY_DN) {
                    if (check_move(menu_x, menu_y + 1)) {
                        menu_y += 1;
                    }
                    else {
                        menu_y = 0;
                        if (fsel_hasnextpage) {
                            fsel_pagestart += FSEL_PAGESIZE - 2;
                        }
                        else {
                            fsel_pagestart = 0;
                        }
                        invalidate();
                    }
                }

                if (joy_status & JOY_LT) {
                    if (check_move(menu_x - 1, menu_y)) {
                        menu_x = menu_x - 1;
                    }
                    else {
                        menu_x = 0; // so that it's saved nicely
                        menu_goto_page(current_page == PAGE_FSEL_FIRST ? PAGE_FSEL_LAST : current_page - 1);
                        menu_x = 1;
                    }
                }

                if (joy_status & JOY_RT) {
                    if (check_move(menu_x + 1, menu_y)) {
                        menu_x = menu_x + 1;
                    }
                    else {
                        menu_x = 1; // to save it nicely
                        menu_goto_page(current_page == PAGE_FSEL_LAST ? PAGE_FSEL_FIRST : current_page + 1);
                        menu_x = 0;
                    }
                }

                invalidate_fsel();

                if (joy_status & JOY_FIRE) {
                    state = STATE_FILESELECTED;
                }

                break;
        }
    }

    if (invalid & INVALID_VIEW) {
        switch (state) {
            case STATE_MENU:
                draw_menu();
                break;
            case STATE_FSEL:
                draw_fsel_page();
                draw_fsel();
                adjust_fsel();
                break;
        }
    }

    if (invalid & INVALID_FSEL) {
        fsel_showselection(0);
        menu_selected = menu_y * 2 + menu_x;
        fsel_showselection(1);
    }

    invalid = 0;

    return result;
}

void init_pages()
{
    for (int i = 0; i < N_PAGES; ++i) {
        pages[i].page_start = 0;
        pages[i].sel_x = pages[0].sel_y = 0;
    }
    pages[0].sel_x = pages[0].sel_y = 1;
    current_page = 0;
    return_to_page = PAGE_FSEL_FIRST;

    pages[1].filter = FK_FDD; 
    pages[2].filter = FK_ROM;
    pages[3].filter = FK_CAS;
    pages[4].filter = FK_WAV;
    pages[5].filter = FK_EDD;
}

void menu_init() {
    init_pages();
    menu_goto_page(0);
}

void save_page_state(int page)
{
    if (page >= 0 && page < N_PAGES) {
        pages[page].page_start = fsel_pagestart;
        pages[page].sel_x = menu_x;
        pages[page].sel_y = menu_y;
    }
}

void menu_goto_page(int page)
{
    save_page_state(current_page);
    osd_cls(1);
    if (current_page != 0) {
        return_to_page = current_page;
    }
    current_page = page;
    switch (page) {
        case 0:
        default:
            state = STATE_MENU;
            menu_x = 1;
            menu_y = 1;
            menu_selected = 0377;
            osdcmd &= 1;        // clear reset bits, keep hold
            OSD_CMD = osdcmd;
            break;
        case 1:
        case 2:
        case 3:
        case 4:
        case 5:
            philes_setfilter(pages[current_page].filter);
            menu_x = pages[current_page].sel_x;
            menu_y = pages[current_page].sel_y;
            fsel_pagestart = pages[current_page].page_start;
            invalidate_fsel();
            break;
    }

    invalidate();
}

void draw_menu() {
    int m_y, m_x, item = 0;
    for (m_y = 0; m_y < 3; m_y++) {
        for (m_x = 0; m_x < 3; m_x++) {
            osd_inv((m_y == menu_y) && (m_x == menu_x));
            draw_item(menu_item[item], 5 + m_x * 10, m_y+2, ALIGN_MIDDLE);
            item++;
        }
    }

    osd_inv(0); draw_item(ptrfile, 16, 6, ALIGN_MIDDLE);

    osd_inv(0); osd_gotoxy(0,7); osd_puts(TXT_MENU_HALP);
}

void draw_item(char *s, uint8_t x, uint8_t y, uint8_t align) {
    int len;

    if (!s) 
        return;

    len = strlen(s);
    switch (align) {
        case ALIGN_MIDDLE:
            x -= len/2;
            break;
        case ALIGN_LEFT:
            break;
        case ALIGN_RIGHT:
            x -= len;
            break;
    }

    osd_gotoxy(x, y);
    osd_puts(s);
}

void switch_state(void) {
    if (state == STATE_WAITBREAK) {
        switch (menu_selected) {
            case SEL_HOLD:
                osdcmd ^= 1;    // toggle hold (pause host)
                OSD_CMD = osdcmd;
                state = STATE_MENU;
                break;
            case SEL_RESET:
                osdcmd |= 4;
                OSD_CMD = osdcmd;
                osdcmd &= ~4;
                OSD_CMD = osdcmd;
                state = STATE_MENU;
                break;
            case SEL_RESTART:
                osdcmd |= 2;
                OSD_CMD = osdcmd;
                osdcmd &= ~2;
                OSD_CMD = osdcmd;
                state = STATE_MENU;
                break;
            case SEL_ABOUT:
                state = STATE_ABOOT;
                aboot_show();
                break;
            case SEL_DISK:
                menu_goto_page(return_to_page);
                state = STATE_FSEL;
                break;
            default:
                state = STATE_MENU;
                break;
        }
    } 
}

uint8_t fsel_index2offs(uint8_t idx) {
    return 33 + (idx/2)*32 + (idx % 2)*16;
}

// set fsel_pagestart to the beginning of the last page
void find_last_pagestart()
{
    if (philes_opendir() == FR_OK) {
        fsel_pagestart = 0;
        while (1) {
            for (int i = 0; i < FSEL_PAGESIZE; ++i) {
                if (philes_nextfile(0, 0) != FR_OK) {
                    return;
                }
            }
            fsel_pagestart += FSEL_PAGESIZE;
        }
    }
}

void draw_fsel_page(void)
{
    if (current_page < PAGE_FSEL_FIRST || current_page > PAGE_FSEL_LAST)
        return;

    osd_inv(0); osd_gotoxy(0,7);// osd_puts(TXT_MENU_HALP);
    osd_puts(" FDD  ROM  CAS  WAV  EDD ");

    uint8_t *uptr = dmem + 7 * 32 + (current_page - 1) * 5;
    for (int i = 0; i < 5; ++i) {
        *uptr++ |= 0200;
    }
}

void draw_fsel(void) {
    int32_t i;
    uint8_t *uptr;

    // if rolling back over 0, find start of last page
    if (fsel_pagestart < 0) {
        find_last_pagestart();
    }

    fsel_hasnextpage = 1;
    ser_puts("opendir");

    int nfiles = 0;
    if (philes_opendir() == FR_OK) {
        ser_puts(" ok"); ser_nl();

        // skip until pagestart
        if (fsel_pagestart > 0) {
            for (i = 0; i < fsel_pagestart; ++i) {
                if (philes_nextfile(0, 0) != FR_OK) {
                    fsel_pagestart = 0;
                    break;
                }
            }
        }

        // show files
        for (i = 0; i < FSEL_PAGESIZE; ++i) {
            uptr = dmem + fsel_index2offs(i);
            memset(uptr, 32, 12);
            if (philes_nextfile((char *)uptr, 0) != FR_OK) {
                fsel_hasnextpage = 0;
                // keep filling the screen though
            }
            else {
                ++nfiles;
            }
        }

        if (nfiles == 0) {
            uptr = dmem + fsel_index2offs(0);
            memset(uptr, 32, 12);
            strcpy((char *)uptr, "<NO FILES>");
        }
    }
}

void fsel_showselection(uint8_t on) {
    uint8_t * uptr = dmem + fsel_index2offs(menu_selected);
    uint8_t i = 12;

    while (i--) uptr[i] = on ? uptr[i] | 0200 : uptr[i] & 0177;
}

void fsel_getselected(char *file) {
    uint8_t * uptr = dmem + fsel_index2offs(menu_selected);
    uint8_t u;
    uint8_t i = 12;
    while (i-- && ((u = 0177 & *uptr++) != 32)) {
        *file++ = u;
    }
    *file++ = '\000';
}



const uint8_t waverseq[] = {0,0,1,1,0,0,1,1,2,3,2,3,2,3,2,3};

void aboot_show() {
    osd_cls(1);
    osd_gotoxy(0,1); osd_puts(cnotice2);
    osd_gotoxy(0,2); osd_puts(aboot2);
    osd_gotoxy(0,3); osd_puts(aboot3);
    osd_gotoxy(0,4); osd_puts(aboot4);
    osd_gotoxy(0,5); osd_puts(aboot5);
    osd_gotoxy(0,6); osd_puts(aboot6);
    dude_seqno = 0;
}

void aboot_anim() {
    uint8_t i;

    for (i = 0; i < 3; i++) {
        osd_gotoxy(28, i+3); osd_puts(dude[waverseq[dude_seqno]*3+i]);
    }
    dude_seqno = (dude_seqno + 1) % 16;

    delay2(10);
}
