svofski/vector06cc/src/floppy/neo430/neo430_cpu.v

module neo430_addr_gen
  (input  clk_i,
   input  [15:0] reg_i,
   input  [15:0] mem_i,
   input  [15:0] imm_i,
   input  [1:0] irq_sel_i,
   input  [28:0] ctrl_i,
   output [15:0] mem_addr_o,
   output [15:0] dwb_o);
  wire [15:0] mem_addr_reg;
  wire [15:0] addr_add;
  wire [2:0] n1524_o;
  wire n1526_o;
  wire n1528_o;
  wire n1530_o;
  wire n1532_o;
  wire [3:0] n1533_o;
  reg [15:0] n1537_o;
  wire [15:0] n1538_o;
  wire n1542_o;
  wire n1543_o;
  wire n1544_o;
  wire [15:0] n1545_o;
  wire n1550_o;
  wire n1551_o;
  wire [2:0] n1553_o;
  localparam [15:0] n1554_o = 16'b1100000000000000;
  wire [12:0] n1555_o;
  wire [15:0] n1556_o;
  wire [15:0] n1557_o;
  wire [15:0] n1558_o;
  wire [15:0] n1560_o;
  reg [15:0] n1561_q;
  assign mem_addr_o = n1558_o;
  assign dwb_o = addr_add;
  /* core/neo430_addr_gen.vhd:63:10  */
  assign mem_addr_reg = n1561_q; // (signal)
  /* core/neo430_addr_gen.vhd:64:10  */
  assign addr_add = n1538_o; // (signal)
  /* core/neo430_addr_gen.vhd:73:16  */
  assign n1524_o = ctrl_i[22:20];
  /* core/neo430_addr_gen.vhd:74:7  */
  assign n1526_o = n1524_o == 3'b000;
  /* core/neo430_addr_gen.vhd:75:7  */
  assign n1528_o = n1524_o == 3'b001;
  /* core/neo430_addr_gen.vhd:76:7  */
  assign n1530_o = n1524_o == 3'b010;
  /* core/neo430_addr_gen.vhd:77:7  */
  assign n1532_o = n1524_o == 3'b011;
  assign n1533_o = {n1532_o, n1530_o, n1528_o, n1526_o};
  /* core/neo430_addr_gen.vhd:73:5  */
  always @*
    case (n1533_o)
      4'b1000: n1537_o = 16'b1111111111111110;
      4'b0100: n1537_o = 16'b0000000000000010;
      4'b0010: n1537_o = 16'b0000000000000001;
      4'b0001: n1537_o = imm_i;
      default: n1537_o = mem_i;
    endcase
  /* core/neo430_addr_gen.vhd:80:51  */
  assign n1538_o = reg_i + n1537_o;
  /* core/neo430_addr_gen.vhd:92:17  */
  assign n1542_o = ctrl_i[26];
  /* core/neo430_addr_gen.vhd:93:19  */
  assign n1543_o = ctrl_i[23];
  /* core/neo430_addr_gen.vhd:93:40  */
  assign n1544_o = ~n1543_o;
  /* core/neo430_addr_gen.vhd:93:9  */
  assign n1545_o = n1544_o ? reg_i : addr_add;
  /* core/neo430_addr_gen.vhd:107:15  */
  assign n1550_o = ctrl_i[24];
  /* core/neo430_addr_gen.vhd:108:17  */
  assign n1551_o = ctrl_i[25];
  /* core/neo430_addr_gen.vhd:110:45  */
  assign n1553_o = {irq_sel_i, 1'b0};
  assign n1555_o = n1554_o[15:3];
  /* core/neo430_alu.vhd:102:22  */
  assign n1556_o = {n1555_o, n1553_o};
  /* core/neo430_addr_gen.vhd:108:7  */
  assign n1557_o = n1551_o ? n1556_o : reg_i;
  /* core/neo430_addr_gen.vhd:107:5  */
  assign n1558_o = n1550_o ? n1557_o : mem_addr_reg;
  /* core/neo430_addr_gen.vhd:91:5  */
  assign n1560_o = n1542_o ? n1545_o : mem_addr_reg;
  /* core/neo430_addr_gen.vhd:91:5  */
  always @(posedge clk_i)
    n1561_q <= n1560_o;
endmodule

module neo430_alu
  (input  clk_i,
   input  [15:0] reg_i,
   input  [15:0] mem_i,
   input  [15:0] sreg_i,
   input  [28:0] ctrl_i,
   output [15:0] data_o,
   output [4:0] flag_o);
  wire [15:0] op_data;
  wire [15:0] op_a_ff;
  wire [15:0] op_b_ff;
  wire [17:0] add_res;
  wire [15:0] alu_res;
  wire [15:0] data_res;
  wire zero;
  wire negative;
  wire parity;
  wire n1084_o;
  wire n1085_o;
  wire [15:0] n1086_o;
  wire n1089_o;
  wire n1091_o;
  wire [3:0] n1109_o;
  wire n1111_o;
  wire [3:0] n1112_o;
  wire n1114_o;
  wire n1115_o;
  wire [15:0] n1116_o;
  wire [15:0] n1117_o;
  wire n1120_o;
  wire [3:0] n1121_o;
  wire n1123_o;
  wire [3:0] n1124_o;
  wire n1126_o;
  wire n1127_o;
  wire n1128_o;
  wire n1129_o;
  wire [7:0] n1130_o;
  wire [8:0] n1132_o;
  wire [7:0] n1133_o;
  wire [8:0] n1135_o;
  wire [7:0] n1136_o;
  wire [8:0] n1138_o;
  wire [7:0] n1139_o;
  wire [8:0] n1141_o;
  wire [8:0] n1142_o;
  wire [8:0] n1143_o;
  wire [8:0] n1144_o;
  wire [8:0] n1145_o;
  wire n1146_o;
  wire [8:0] n1147_o;
  wire [8:0] n1148_o;
  wire n1149_o;
  wire n1150_o;
  wire n1151_o;
  wire n1152_o;
  wire n1153_o;
  wire n1154_o;
  wire n1155_o;
  wire n1156_o;
  wire n1157_o;
  wire n1158_o;
  wire n1159_o;
  wire n1160_o;
  wire n1161_o;
  wire n1162_o;
  wire n1163_o;
  wire n1164_o;
  wire n1165_o;
  wire n1166_o;
  wire n1167_o;
  wire n1168_o;
  wire n1169_o;
  wire n1170_o;
  wire n1171_o;
  wire n1172_o;
  wire n1173_o;
  wire n1174_o;
  wire n1175_o;
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
  wire n1484_o;
  wire n1485_o;
  wire n1486_o;
  wire n1487_o;
  wire n1488_o;
  wire n1489_o;
  wire n1490_o;
  wire n1491_o;
  wire n1492_o;
  wire n1493_o;
  wire n1494_o;
  wire n1495_o;
  wire n1496_o;
  wire n1497_o;
  wire n1498_o;
  wire n1499_o;
  wire n1500_o;
  wire n1501_o;
  wire n1502_o;
  wire n1503_o;
  wire n1504_o;
  wire n1506_o;
  wire n1508_o;
  wire n1509_o;
  wire n1510_o;
  wire n1511_o;
  wire [15:0] n1512_o;
  reg [15:0] n1513_q;
  wire [15:0] n1514_o;
  reg [15:0] n1515_q;
  wire [17:0] n1516_o;
  wire [15:0] n1517_o;
  wire [15:0] n1518_o;
  wire [4:0] n1519_o;
  assign data_o = data_res;
  assign flag_o = n1519_o;
  /* core/neo430_alu.vhd:62:10  */
  assign op_data = n1086_o; // (signal)
  /* core/neo430_alu.vhd:63:10  */
  assign op_a_ff = n1513_q; // (signal)
  /* core/neo430_alu.vhd:64:10  */
  assign op_b_ff = n1515_q; // (signal)
  /* core/neo430_alu.vhd:65:10  */
  assign add_res = n1516_o; // (signal)
  /* core/neo430_alu.vhd:66:10  */
  assign alu_res = n1517_o; // (signal)
  /* core/neo430_alu.vhd:67:10  */
  assign data_res = n1518_o; // (signal)
  /* core/neo430_alu.vhd:68:10  */
  assign zero = n1465_o; // (signal)
  /* core/neo430_alu.vhd:69:10  */
  assign negative = n1510_o; // (signal)
  /* core/neo430_alu.vhd:70:10  */
  assign parity = n1506_o; // (signal)
  /* core/neo430_alu.vhd:76:32  */
  assign n1084_o = ctrl_i[12];
  /* core/neo430_alu.vhd:76:52  */
  assign n1085_o = ~n1084_o;
  /* core/neo430_alu.vhd:76:20  */
  assign n1086_o = n1085_o ? reg_i : mem_i;
  /* core/neo430_alu.vhd:85:17  */
  assign n1089_o = ctrl_i[13];
  /* core/neo430_alu.vhd:88:17  */
  assign n1091_o = ctrl_i[14];
  /* core/neo430_alu.vhd:108:15  */
  assign n1109_o = ctrl_i[18:15];
  /* core/neo430_alu.vhd:108:56  */
  assign n1111_o = n1109_o == 4'b0101;
  /* core/neo430_alu.vhd:109:15  */
  assign n1112_o = ctrl_i[18:15];
  /* core/neo430_alu.vhd:109:56  */
  assign n1114_o = n1112_o == 4'b0110;
  /* core/neo430_alu.vhd:108:69  */
  assign n1115_o = n1111_o | n1114_o;
  /* core/neo430_alu.vhd:113:23  */
  assign n1116_o = ~op_a_ff;
  /* core/neo430_alu.vhd:108:5  */
  assign n1117_o = n1115_o ? op_a_ff : n1116_o;
  /* core/neo430_alu.vhd:108:5  */
  assign n1120_o = n1115_o ? 1'b0 : 1'b1;
  /* core/neo430_alu.vhd:118:15  */
  assign n1121_o = ctrl_i[18:15];
  /* core/neo430_alu.vhd:118:56  */
  assign n1123_o = n1121_o == 4'b0110;
  /* core/neo430_alu.vhd:119:15  */
  assign n1124_o = ctrl_i[18:15];
  /* core/neo430_alu.vhd:119:56  */
  assign n1126_o = n1124_o == 4'b0111;
  /* core/neo430_alu.vhd:118:70  */
  assign n1127_o = n1123_o | n1126_o;
  /* core/neo430_alu.vhd:120:30  */
  assign n1128_o = sreg_i[0];
  /* core/neo430_alu.vhd:118:5  */
  assign n1129_o = n1127_o ? n1128_o : n1120_o;
  /* core/neo430_alu.vhd:126:27  */
  assign n1130_o = n1117_o[7:0];
  /* core/neo430_alu.vhd:126:19  */
  assign n1132_o = {1'b0, n1130_o};
  /* core/neo430_alu.vhd:127:27  */
  assign n1133_o = n1117_o[15:8];
  /* core/neo430_alu.vhd:127:19  */
  assign n1135_o = {1'b0, n1133_o};
  /* core/neo430_alu.vhd:128:28  */
  assign n1136_o = op_b_ff[7:0];
  /* core/neo430_alu.vhd:128:19  */
  assign n1138_o = {1'b0, n1136_o};
  /* core/neo430_alu.vhd:129:28  */
  assign n1139_o = op_b_ff[15:8];
  /* core/neo430_alu.vhd:129:19  */
  assign n1141_o = {1'b0, n1139_o};
  /* core/neo430_alu.vhd:132:52  */
  assign n1142_o = n1132_o + n1138_o;
  /* core/neo430_alu.vhd:132:71  */
  assign n1143_o = {8'b0, n1129_o};  //  uext
  /* core/neo430_alu.vhd:132:71  */
  assign n1144_o = n1142_o + n1143_o;
  /* core/neo430_alu.vhd:133:52  */
  assign n1145_o = n1135_o + n1141_o;
  /* core/neo430_alu.vhd:133:90  */
  assign n1146_o = n1144_o[8];
  /* core/neo430_alu.vhd:133:71  */
  assign n1147_o = {8'b0, n1146_o};  //  uext
  /* core/neo430_alu.vhd:133:71  */
  assign n1148_o = n1145_o + n1147_o;
  /* core/neo430_alu.vhd:136:29  */
  assign n1149_o = n1117_o[15];
  /* core/neo430_alu.vhd:136:19  */
  assign n1150_o = ~n1149_o;
  /* core/neo430_alu.vhd:136:51  */
  assign n1151_o = op_b_ff[15];
  /* core/neo430_alu.vhd:136:40  */
  assign n1152_o = ~n1151_o;
  /* core/neo430_alu.vhd:136:35  */
  assign n1153_o = n1150_o & n1152_o;
  /* core/neo430_alu.vhd:136:69  */
  assign n1154_o = n1148_o[7];
  /* core/neo430_alu.vhd:136:57  */
  assign n1155_o = n1153_o & n1154_o;
  /* core/neo430_alu.vhd:136:84  */
  assign n1156_o = n1117_o[15];
  /* core/neo430_alu.vhd:136:100  */
  assign n1157_o = op_b_ff[15];
  /* core/neo430_alu.vhd:136:89  */
  assign n1158_o = n1156_o & n1157_o;
  /* core/neo430_alu.vhd:136:122  */
  assign n1159_o = n1148_o[7];
  /* core/neo430_alu.vhd:136:110  */
  assign n1160_o = ~n1159_o;
  /* core/neo430_alu.vhd:136:105  */
  assign n1161_o = n1158_o & n1160_o;
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
  assign n1492_o = data_res[10];
  /* core/neo430_package.vhd:1030:22  */
  assign n1493_o = n1491_o ^ n1492_o;
  /* core/neo430_package.vhd:1030:27  */
  assign n1494_o = data_res[11];
  /* core/neo430_package.vhd:1030:22  */
  assign n1495_o = n1493_o ^ n1494_o;
  /* core/neo430_package.vhd:1030:27  */
  assign n1496_o = data_res[12];
  /* core/neo430_package.vhd:1030:22  */
  assign n1497_o = n1495_o ^ n1496_o;
  /* core/neo430_package.vhd:1030:27  */
  assign n1498_o = data_res[13];
  /* core/neo430_package.vhd:1030:22  */
  assign n1499_o = n1497_o ^ n1498_o;
  /* core/neo430_package.vhd:1030:27  */
  assign n1500_o = data_res[14];
  /* core/neo430_package.vhd:1030:22  */
  assign n1501_o = n1499_o ^ n1500_o;
  /* core/neo430_package.vhd:1030:27  */
  assign n1502_o = data_res[15];
  /* core/neo430_package.vhd:1030:22  */
  assign n1503_o = n1501_o ^ n1502_o;
  /* core/neo430_alu.vhd:269:14  */
  assign n1504_o = ~n1503_o;
  /* core/neo430_alu.vhd:269:39  */
  assign n1506_o = 1'b0 ? n1504_o : 1'bX;
  /* core/neo430_alu.vhd:272:23  */
  assign n1508_o = data_res[7];
  /* core/neo430_alu.vhd:272:39  */
  assign n1509_o = ctrl_i[19];
  /* core/neo430_alu.vhd:272:27  */
  assign n1510_o = n1509_o ? n1508_o : n1511_o;
  /* core/neo430_alu.vhd:272:75  */
  assign n1511_o = data_res[15];
  /* core/neo430_alu.vhd:83:5  */
  assign n1512_o = n1089_o ? op_data : op_a_ff;
  /* core/neo430_alu.vhd:83:5  */
  always @(posedge clk_i)
    n1513_q <= n1512_o;
  /* core/neo430_alu.vhd:83:5  */
  assign n1514_o = n1091_o ? op_data : op_b_ff;
  /* core/neo430_alu.vhd:83:5  */
  always @(posedge clk_i)
    n1515_q <= n1514_o;
  /* core/neo430_alu.vhd:83:5  */
  assign n1516_o = {n1185_o, n1179_o};
  assign n1517_o = {n1411_o, n1400_o, n1389_o, n1378_o, n1367_o, n1356_o, n1345_o, n1334_o, n1323_o};
  assign n1518_o = {n1425_o, n1421_o};
  assign n1519_o = {n1312_o, n1311_o, n1310_o, n1309_o, n1308_o};
endmodule
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
