svofski/vector06cc/(commit log)

2007-11-10 decent moving average audio input, tape loader works but with fixed level so far bootloader modified a little: inserts di; jmp 100 at address 0 instead of cleaning memory
    [I2C_AV_Config.v, soundcodec.v, vector06cc.v]
2007-11-12 keyboard: shift+arrows issue fixed AUDIO_DAC->audio_io
    [audio_io.v, soundcodec.v, vector06cc.v, vectorkeys.v]
2007-11-13 fixed maddemo and m@demo resetting -- second peripheral port returns 0x00!
    [soundcodec.v, vector06cc.v]
2007-11-14 proper? haha video mode 800x600@50Hz, pretty close but still not perfect
2007-11-21 implemented defines for CPU-less, keyboard-less and timer-less builds started work on slow-time double scanner, `ifdef DOUBLE_BUFFER
2007-11-29 new timings: waitstates chosen according to the original Vector device timings fixed for m@color and dizzyrek2, basic korvet works too proper scan doubler allows for realtime effects text on border w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
    awesomeness!
    [clockster.v, oneshot.v, vector06cc.v]
2007-11-29 new timings: waitstates chosen according to the original Vector device timings fixed for m@color and dizzyrek2, basic korvet works too proper scan doubler allows for realtime effects text on border w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
    (also T80 fixed to have proper timings)
    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
    [T80_MCode.vhd, framebuffer.v, video.v]
2007-12-16 Updates xcoloridx on negedge of clk24. Used to be fully async assignment. In theory this could resolve some compatibility issues. In practice it is reported that it still doesn't work in Quartus 6.1.
    [video.v]
2007-12-18 #1 keyboard shift-stuck, solved
    [vectorkeys.v]
2007-12-19 jtag interference fixed only brutally so far, must investigate how to reset HOLD if command wasn't SRAM related
    [CMD_Decode.v, T8080se.vhd, jtag_top.v, vector06cc.v]
2007-12-19 jtag transparency sort of resolved, but with magic - tkx usb api software; SW7 is manual bus hold just for a case
    [CMD_Decode.v, vector06cc.v]
2007-12-24 new 100hz timer for floppy
2007-12-24 the timer itself
2007-12-24 workbench: timer in project
2007-12-24 floppy/workbench: timers now work
2007-12-24 oopsie, forgot timer.h timer.c
2007-12-24 spi module
2007-12-29 buffer read tests. currently works on 1 clock
2007-12-30 READADDR command (cpu relay), more simulation testing, some dubious optimizations
2008-01-06 some fixes in firmware
    [main.c, serial.c, serial.h, slave.c]
2008-01-06 reduced ram to 18K, fixed what prevented wd1793 to be really instantiated (stuck data)
    [floppy.v, floppywb.v, main.c, slave.c]
2008-01-12 write fails correctly, big rehash of wd1793 code for readability mostly, optimized a bit too
    [slave.c, slave.h, wd1793.v]
2008-01-12 seek instruction fixed, takes data from data register
    [fddimage.c, slave.c, wd1793.v]
2008-01-12 fixed busy states for restore and seek; also licenses
    [vector06cc.v, wd1793.v]
2008-01-13 seek/readadr issue fixed, ay level adjusted
    [ayglue.v, slave.c, soundcodec.v, vector06cc.v, wd1793.v]
2008-01-13 route data through data reg; fixes issue with fdc detection
    [wd1793.v]
2008-01-13 shortened fdc startup delay; moved disk.hex to the top dir and added it to the repository
    [main.c]
2008-01-14 replaced priority encoder for perihperal data-in with a selector, fixed timing issues
    [vector06cc.v]
2008-01-15 T80: fixed DAA to be 8080-grade broken Fixed palette writes, now the bus is routed like in the original (no address override on out 0c) Fixed (removed) silly .fdd file check
    [T80_ALU.vhd, ayglue.v, slave.c, vector06cc.v]
2008-01-15 adjustable verbosity (serial debug) fddimage: NSECTORS, SECTOR_SIZE, NSIDES made constants tff: NTFLAG set to 0, no need to preserve case
2008-01-16 cpm programs: cpu test and timer test
2008-01-17 shut up the timer after the test is over
2008-01-17 kvaz: changed to selectors instead of priority encoder, hoping for more stable operation 8253: changed all to posedge; skip one tce after counter load (seems to be more like the original) the test (s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
    firmware: sort of "automount" implemented, now one can remove sd card, insert it with another file and it would
    be as if a disk was replaced; although one bdos error has to happen for remount attempt to be made
    [8253.v, kvaz.v, main.c, slave.c]
2008-01-17 reverted back to rev.82: selector doesn't work as expected (tested with Scaner5)
    [kvaz.v]
2008-01-17 Fixed: terminal count in M2 in 8253 vga refresh: Vector had 624-line mode soundcodec: toned down timer/tape sounds to tolerable levels
    [8253.v, soundcodec.v, vector06cc.v, vga_refresh.v]
2008-01-17 Fail when drive B is selected
    [slave.c, wd1793.v]
2008-01-19 slightly reduced code: wd1793: fixed (?) reset instruction $D0; not sure how it worked before ($80, same as read sectors) fddimage: 1024 cancels out in top/bottom slave: handles SLAVE_STATUS on exit 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
    [fddimage.c, mmc.c, slave.c, tff.c, tff.h, wd1793.v]
2008-01-19 Timer latch test
2008-01-23 Danger: revised all 8080 instructions for TState count: changed quite a few to match i8080 datasheet and manuals
    vga_refresh: a slightly cleaner rewrite of y-states (bonus: LE count dropped to 74 from 99)
    Changed interrupt logic a little bit:
    interrupt request holds for 192 cycles, or until INTA. Probably still wrong,
    it should hold until the border starts even though there's hardly any use for that.
    SkyNet still seems to be overly sensitive to interrupt times, nothing seems to really satisfy this monster, although some values of delay allow it to pass past the cursed photo part.
    Resume: this is a generally poorly tested commit made out of fear of losing too much at once.
    [T80_MCode.vhd, vector06cc.v, vga_refresh.v]
2008-01-24 textmode x-wraparound fixed (somewhat) y-wraparound still there
    [textmode.v]
2008-01-24 linediv vs. clock enable fixed
    [textmode.v]
2008-01-26 OSD now can perform restart, hold, reset floppy images are actually selectable! retrace interrupt converted into a latch, reset by ~INTE.. seems to be working fine
    [floppy.v, main.c, menu.c, menu.h, philes.c, philes.h]
2008-01-26 slightly better error recovery after the sd card was removed/missing
    [menu.c, menu.h, slave.c]
2008-01-29 in i82c55 -- uncommented port clear on mode set; musician.rom doesn't jump its screen then, can't be 100% sure about the rest ay -- fixed reading from registers moved out fake 8255 "pu" to a separate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
    [ayglue.v, i82c55.vhd, vector06cc.v]
2008-01-31 DMA! Very fast floppy now. Instantaneous.
2008-02-08 + wd1793 status bit 7:notready now indicates presence of SD card in slot (a posterior) + in CPU_STATUS bit 2:crc (rw error) and bit 3:notready (media removed) + sw23 == 2'b10 shows actual floppy stat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
    Firmware:
    + support bits 2,3 in the status word
    + recover after a wrong/empty image file was selected (e.g. after sd card removal)
    [floppy.v, slave.c, slave.h, vector06cc.v, wd1793.v]
2008-02-11 DMA for disk write ops
2008-02-12 WARNING: a barely working state, before fixing the WRITE/BUSY problem
    [USB_JTAG.v, YM2149_linmix.vhd, ayglue.v, config.h, dma_rw.v, floppy.v, i82c55.vhd, textmode.v]
2008-02-19 write mode:
    rewrote state machines, added a lot of states to wd1793, mostly to make operation more transparent;
    write works (except for the infamous D>Q in large directories); c compilation test passes.
    still needs a major review before calling complete.
    the host still loves to call abort ($D0) during write operation for some reason; probably it has to do
    with BUSY status and can only be workarounded, as it now is: slave.c saves the current command and
    reuses it later instead of relying on register content.
    [config.h, slave.c, slave.h, vector06cc.v, wd1793.v]
2008-02-21 Weird state, but most workable so far. Write mostly works. C programs can be compiled, but CC would not always launch CC2; D>Q still fails. It seems that a lot actually depends on timing, even during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
    [config.h, floppy.v, slave.c, vector06cc.v, wd1793.v]
2008-02-22 $D0 command: reset cmd_mode to 0, clear error bits only when state == STATE_READY --> D>Q works!
    [vector06cc.v, wd1793.v]
2008-02-23 Some workarounds for the keys that have different matrix positions depending on shift status.
    [scan2matrix.v, vectorkeys.v]
2008-08-27 fixed all stack instructions to generate proper STACK cycles SkyNet demo now works flawlessly! implemented but left out rudimentary breakpoint device qsf file now adjusted to QII WE 8.0sp1 configurat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
    [T80_MCode.vhd, vector06cc.v]
2008-08-27 port C bits 3:0 should read as '1', this fixes Kolobiha
    [vector06cc.v]
2009-02-05 in vector06cc: interrupt request is now only EDGE-SENSITIVE in soundcodec: fixed signed audio in problem, added hysteresis in I2C_AV_Config: lowered audio in gain to 0 dB
    [I2C_AV_Config.v, soundcodec.v, vector06cc.v]
2009-09-03 Basic composite output on VGA connector.
    When SW5 is ON:
    VGA.HSYNC = SYNC
    VGA.R = VIDEO
    When SW5 is OFF VGA connector works as usual.
    No PAL encoder and the intensities are false, to be done yet.
2009-09-15 R,G,B joined in one signal to drive signle CVSB wire, SW5 = 1 --> CVSB, SW5 == 0 --> VGA
2009-09-16 fixed sound codec clock OSD now works in TV mode SW4 toggles pal field phase alternation
    [clockster.v, vector06cc.v, video.v]
2009-09-16 Fixed OSD to be in screen area in TV mode.
    [video.v]
2009-09-16 Reduced whistling noise in SkyNet:
    - 18MHz derived from a phase accumulator
    - 14MHz still made by simple division, AY woldn't work with phase accu for some reason? Unsure
    [clockster.v]
2009-09-18 T80/8080 Mode (Mode 2) CPU Fixes: 1. ALU-based subtractions have AC flag inverted, SUB/SBB/DCR... 2. RRC/RLC/RAL/RAR only modify C flag 3. STC/CMC/CMA do not change AC flag 4. ALU AND operation sets 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
    The fixes above make this core pass all known 8080 CPU tests.
    Results of 8080 Executioner match those of real CPU, tested on Vector-06c with KR580VM80A.
    Audio clocks are generated by another PLL for the time being: tape loading didn't work otherwise.
    [T80.vhd, T80_ALU.vhd, clockster.v]
2009-09-20 warp mode 12 (6) MHz with floppy support
    [vector06cc.v, wd1793.v]
2009-10-01 1) 2pi/8 clock step for PAL encoder: saturation, no field interleave (leave SW4=off) 2) adjusted the clock drum to match IRL v06c (tested by raster effects on real), timer CE adjusted accordingly 3) 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
2009-10-04 dirty but working fixes for all modes
    [8253.v]
2010-05-30 Switch descriptions in the comments
2011-03-07 1) added ce6x that runs at 1 mclk earlier: this allowed to make address selection in video.v on posedge 2) fixed palette in 512x256 mode 3) used named ports in palette_ram instantiation
    [clockster.v, vector06cc.v, video.v]
2011-03-08 reverted to negedge in pixel pusher because of regress with tv output
    [clockster.v, video.v]
2014-01-06 Revised version that should be compatible with newer DE1 boards with slow SRAM: * registered rom_access to reduce propagation delay on SRAM_OE_N (should be around 8.6 relative to clk50) * big clean u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
2014-02-11 Cleaned up SRAM access signals a lot, but apparently still incompatible with newer DE1 revisions.
    [framebuffer.v, oneshot.v, sram_map.v, vector06cc.v]
2014-02-12 Warp mode for SDRAM version (SDRAM at 120 MHz now), compatibility with Z80
    [SDRAM_Controller.v, vector06cc.v]
2014-02-13 framebuffer.v for 120 MHz SDRAM version (it was forgotten to commit)
2014-02-17 It's like 394 with minor changes in memory access. Something like warp (3 MHz with no waitstates) added.
    [SDRAM_Controller.v, framebuffer.v, vector06cc.v]
2014-03-10 Good warp (almost 6 MHz) now, SDRAM works at 60 MHz
    [SDRAM_Controller.v, clockster.v, vector06cc.v]
2014-03-11 Warp mode 50% faster than in revision 401 and even 30% faster than in SRAM versions. Measured by 8080exe7.com running time
    [SDRAM_Controller.v, clockster.v, vector06cc.v]
2014-05-05 R-Sound support added. Sound codec now works in DSP mode with 12 MHz clock - no more funny sounds in SKYNET. Some switches (SW6/7/9) now unused.
2014-05-06 video.v and framebuffer.v updated
2014-07-07 port to WXEDA Cyclone IV board with SDRAM
2014-07-08 loading from tape works (warning! the board requires change: C22 = 22uF, R12 = R32 = 10K)
2014-07-08 +SD card/floppy +PWM beeper sound (horrible)
2014-07-15 + compile.bat - vector.lib (it should be assembled by cc65 build)
2014-07-16 * s-video output on separate pins (pwm) * some compromises in OSD which makes it simultaneously usable on both VGA and TV * R-Sound support made optional
2014-07-16 fixed S-Video chroma overflow
    [video.v]
2014-07-19 adjusted composite (pwm) out to work with new changes
2014-08-14 + missing files as requested in #44
    [vector06cc.v]
2016-01-30 mixing fixes by ivagor
    [soundcodec.v]
2016-02-06 buildable cc65 as submodule
    resolved Conflicts:
    build/Makefile
    firmware/floppysrc/Makefile
    firmware/floppysrc/menu.c
    firmware/floppysrc/slave.c
    [fddimage.h, menu.c, menu.h, philes.h, serial.c, serial.h, slave.c]
2016-02-06 sorting project files by board
2016-02-06 cherry-picked targetful Makefile (warning: current wxeda) Makefile
    Conflicts:
    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
2016-02-06 Revert "project branch cleanup"
    This partially reverts commit c4d334f0f94bee813a160833f562a0929419fb24, hopefully making it easier to merge back with sdram branch
    [CLK_LOCK.v, CMD_Decode.v, I2C_AV_Config.v, I2C_Controller.v, SEG7_LUT.v, USB_JTAG.v]
2016-02-07 merging sram and sdram branches
    cherry-picked:
    in i82c55 -- uncommented port clear on mode set; musician.rom doesn't jump its screen then, can't be 100% sure about the rest
    ay -- fixed reading from registers
    moved out fake 8255 "pu" to a separate module
    [ayglue.v, framebuffer.v, oneshot.v, sram_map.v, vector06cc.v]
2024-04-19 tang nano 9k
    PSRAM + 8x kvaz, 800x480 lcd no scaling, serial console debugger
    [gao1_core0_window0.csv]
2024-04-21 minesweeper mode512 fix
    replaced old 80c55.vhd with b2m's k580vv55.v
    the old version does not support reading from the latch so reading port
    2 reads back 0, which is incorrect.
    [clockster.v, framebuffer.v, k580vv55.v, oneshot.v, psram_controller.v, specialkeys.v, vector06cc.v, video.v]
2024-04-28 vertical scaling to 480 lines, 50hz ok
2024-04-28 F11/F12 support in serial debug probe
2024-05-05 serial keyboard, fixed left column display
    [config.v, framebuffer.v, haltmode.v, palette_ram.v, palette_ram_tmp.v, ps2k.v, rambuffer.v, scan2matrix.v]
2024-05-11 floppy works
    but it's terrible
    had to add hacks special for Gowin
    couldn't use Arlet's 6502 because Gowin hates it
    builds are rather unstable
    [8253.v, config.v, dma_rw.v, floppy.v, main.c, menu.c, philes.c, ram.v]
2024-05-17 Arlet 6502 works
    but can't remove dma, reasons unknown. everything blacks out
2024-05-18 works with gao, doesn't work without. sigh.
    [config.h, floppy.v, haltmode.v, rom.v, vector06cc.v, vram.v]
2024-05-20 switched to Vslav's vm80a
    goodbye T8080
2024-05-21 disk/osd is healthy
    still weird how everything can go completely dead because of a slightest
    change.
    menu, file selection, vram read works
    there are traces of attempts to change vram to single-port
2024-05-30 neo430: v06c boots into necrodos, loads games etc
    OSD is not working yet
    [ayglue.v, config.h, config.v, diskio.h, fddimage.c, fddimage.h, floppy_testbench_neo430.v, integer.h]
2024-05-31 osd + floppy ok
    - connected the osd buffer, some fixes in the code here and there, all
    good
    - vm80a turns out to be problematic yet, the timings are not correct
    which breaks multicolor
    [config.v, menu.c, philes.c, philes.h, slave.c, specialio.h, textmode.v, vector06cc.v]
2024-06-01 vm80a works with correct timings
    [config.v, floppy_neo430.v, neo430_cpu.v, uart.v, vector06cc.v]
2024-08-14 big osd, pwm stereo, pipico hid keyboard
2024-08-16 audio improvements
    updated pwm clock to 72mhz
    pwm resolution increased to 10 bits
    moved pwm gpio to the 3v3 bank, preferred for driving 3v3 external logic
2024-08-18 rom loading works!
    there seem to be some problems:
    * you need to f1+f11 reset for some roms, probably has to do with
    clearing memory
    * F11 sometimes locks up
    * the list of files seems to be short, maybe a tff problem?
    [floppy_neo430.v, menu.c, philes.c, philes.h, romload.c, serial.h, slave.c]
2024-08-19 rom loading, fixed some problems with file browser
    [config.h, fddimage.c, fddimage.h, ff.c, ff.h, ffconf.h, main.c, menu.c]
2024-08-22 clear the LCD at powerup
    use a completely different raster generator to blank out all pixels on
    the LCD, then switch it off and let the normal v06c raster take over
2024-08-23 changed timer sampling -> sound quality improved
    8253 was sampled really roughly for the low samplerate codecs
    sigma-delta modulator doesn't need this so we take the current value of
    8253 output, and it sounds amazing in programs that make good use of the
    timer. examples: pwm18i2 (and other pwm sound tests),
    fatax/cronex/bolder and other players by Novikov.
    [soundcodec.v]
2024-08-25 wav loading works (in principle)
    the details need more work, sample rate is treated a bit too liberally
2024-08-26 wav load wip
    some bugs with wav sample loading fixed
    48000 sample rate added, but it doesn't seem to work well, or maybe it's
    16-bit conversion..
    [floppy_neo430.v, serial.h, util.c, vector06cc.v, wav.c, wavload.c]
2024-09-08 floppy irom size expanded to 16K
    moved in linker script so that makefile doesn't point outside (except
    for msp430 sdk)
    this doesn't change BSRAM resource usage
    [config.h, floppy_neo430.v, main.c, menu.c, romload.c, rstrings.c, rstrings.h, serial.h]
2024-09-14 wip korvet cas support
    simulation creates loadable data
    verilog side needs a new samplerate (4800), untested yet
2024-10-17 stable without WITH_SERIAL_PROBE
    also done with memcpubusy rdcpu_finished as clocks, they are sampled
    on negedge psram_clk now.
    this branch is branched from before hdmi clock introduction as that was
    adding its own instabilities which are very hard to deal with all at the
    same time.
    timing closure still isn't looking great, but works well.
    this is all on the 5" ST7262 display. the scaler skips 1 out of 6 hsync
    pulses. it's not compatible with the 7" that allegedly uses HX8264.
    [audio_io.v, config.v, lcd_testbench.v, vector06cc.v]
2024-10-18 fixed smooth scrolling, super happy version
    SCAN_7INCH is here to stay for 800x480 lcd panels
    probably the scrolling fix can be backported to SCAN_5_3 as well, but I
    don't think it's useful at all because that mode is really hacky
    [config.v, vga_refresh.v, video.v]
2024-10-19 psram_controller update, timing at 80.012/0
    changed the state machine to use a full case, apparently it's important
    timing analysis reports clk_psram at 80.012 with zero setup violations
    Important!
    Place option: 1, Clock route order: 1, Route option: 2, Route maxfan: 23
2024-10-20 kicad project
    [v06cc_tn9k.kicad_pcb, v06cc_tn9k.kicad_sch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]
2024-10-20 synchronize reset with vsync (vga_vs)
    I'm not 100% sure on this. Synchronizing with interrupt pulse appears to
    be coming late, synchronizing with vsync works more reliably.
    Somehow this small change tends to break the timings most severely.
    So no 100% timing closure for now, but it works on the boards that I
    could test.
    [vector06cc.v]
2024-10-21 hdmi output works (no sound)
    really weird stability problems, but this particular state seems to be
    working well for me.
    simple moving the picture left or right may completely break it.
    psram second phase clock moved to 135 degrees, somehow it helps.
    place-route options are as usual: 1-1-2
    timing constraints are important, even if they are incorrect. there is
    probably some room for improvement.
    [clockster.v, config.v, floppy_neo430.v, gowin_rpll72.v, gowin_rpll72_tmp.v, hdmi.sv, spi.v]
2024-10-22 PSRAM latches data internally, no negedges anymore
    this seems to help stability, but doesn't solve it
    i could expand visible screen area for example (not checked in).
    it is possible to hear sound, but still impossible to have a stable
    system with hdmi sound
    closure on 72.908 with options 0-1-2
    [config.v, gowin_rpll72.v, gowin_rpll72_tmp.v, hdmi.sv, psram_controller.v, soundcodec.v, vector06cc.v]
